Ovikian/TMEIC-DI-Water-Cooling-Skid-Repo/Documentation/Function Block Descriptions.docx

1. Startup Control Function Block

The function block will first initialize or continue to execute the diagnostics timer, or initialization timer. Boolean values associated with these timers respectively, FLAG.DIAG_DONE and FLAG.INIT_DONE will be set true once the set time has elapsed. The function block when then determines if the system is in a state which could shut down, based on current flags active. If so, the system will immediately release all latches, ignore any request for initialization, and exit. If not, the system will check if the system meets the proper conditions to initialize. If these conditions are met, the system will set the calibration latch (LATCH.CALI) and the initialization latch (LATCH.INIT) to false, and set the diagnostics latch to true. Conditions require that no fault exists, or that if a fault exists, it is bypassing. Bypassing sets all fault flags, and the master fault flag, to false, in order to allow for the system to run. (Note: this does not hide faults, but rather is a simple reset. Any fault that exists will re-trigger the faults if not dealt with properly) If initialization conditions are not met, the system will simply continue forward to the latch sequence. Once the latch sequence is complete, the function block will exit.

2. Latch Sequence

The latch sequence itself is not a function block but a critical mechanism that controls the system state within the startup control function block. This sequence determines if the system is in a diagnostics, initialization, or calibration phase. It does this by controlling three latches (LATCH.DIAG, LATCH.INIT, LATCH.CALI), three in progress flags (FLAG.DIAG_IN_PROGRESS, FLAG.INIT_IN_PROGRESS, FLAG.CALI_IN_PROGRESS) and three done flags (FLAG.DIAG_DONE, FLAG.CALI_DONE, FLAG.INIT_DONE). To enter this sequence, the diagnostics latch must be engaged – otherwise, it will exit the sequence. If engaged, the system will wait for the diagnostics phase to complete. The diagnostics phase is complete once the timer is associated with the diagnostics phase elapses. Once the diagnostics phase is complete, the function block shall enter the initialization phase. Like the diagnostics phase, the system will wait for the initialization phase to be complete through the elapses of the initialization timer. Once this timer has elapsed, the system will enter the calibration latch. Unlike the previous two phases, calibration completion is accomplished once the measured temperature satisfies temperature setpoint specifications (which is controlled outside of this function block). Only once the calibration sequence is complete, will the latch sequence conclude.

3. Fault Check

The fault check function block checks every possible fault flag. If any of the flags are true, then the system sets the master fault flag. Note that faults may be ignored by setting xSIMMODE to True.

4. Shutdown Control

The Shutdown control function block ensures that the system will shutdown under appropriate conditions, by controlling both the system on, and system shutdown flags. When entering this function block, if the system is not on, or is under nominal conditions, the system exits the function block. However, should conditions be met for a shutdown (either by the operator requesting a shutdown, or a fault-based shutdown) the system will begin to shut down, setting the shutdown in progress flag to true (FLAG.SYS_SD_IN_PROGRESS) and starting the shutdown timer. (This timer allows for the system to wind down before turning off). IN the case that the system is in the middle of diagnostics when needing the shutdown (either by the operator or through a fault), then the system will simply switch to the fault or off state (as the system has not been initialized)

5. Pump Actuation

The pump actuation function block controls the two pumps within the cooling skid. When the system enters the function block, it first will determine if the system is attempting to shut down or if the system is off. Should the system be shutting down or be off, then both pumps will receive a signal to shutdown and/or remain off. Otherwise, if the system is running, then the system will check for any request to initialize/reinitialize is active. If no request is present, the system will exit the function block. Otherwise, the non-active pump will be engaged (in the case that no pump is active, such as during a startup, then the primary pump will be engaged).

6. Fan Control

Noah’s Note: I need to modify this to meet requirements :(

7. Temperature Control

The temperature control function block serves as a filter to the PI block, to prevent controller windup, whilst also ensuring that manual control the 3-way valve is feasible. Upon entering the function block, the system will determine if the operator is manually controlling the valve. If so, the system will use the valve which the operator has provided to the system (note, the system will cap the input of the operator’s value at 0° to 90°). When the operator chooses to return control back to the system, the system shall reenter calibration mode. When the system is in calibration mode, it will compare the operator provided setpoint, with the process variable. The system will then control the valve according to the output of the PI controller such that process variable reaches or surpasses the setpoint in the appropriate direction. (That is, if the setpoint is greater than the process variable, the temperature of the system will be heated until the process variables are greater than or equal to the setpoint. The inverse is true if the setpoint is less than the process variable). Once the process variable and setpoint differences meets system requirements, the system will reset the PI controller integral (this resets the error history and prevents overshoot) and exits calibration mode. When the system is not calibrating, it will force the 3-way-valve to conform to the output of the PI controller.

8. Valve P. Controller

The valve P controller is designed to provide redundancy control to the 3-way valve position. The Kp term is set to be

9. Signal Output

The signal output function block behaves by sending the Boolean fan and pump signals to the appropriate output addresses for instrumentation actuation. Additionally, the valve position signal is converted to WORD based value between 0 and 32767, which is then sent to the 3-way valve instrument for actuation

10. Switch Latch

The switch latch function block acts as an interface between Boolean operator inputs (i.e. buttons on the HMI screen) and Boolean values within the PLC program. All inputs from the operator are debounced. If the simulation Boolean value is set to true, then the HMI mapping is ignored, and the value within the PLC (forced by the operator) is used instead. Otherwise, if the align override Boolean is set to true, then the Boolean value of the operator will always equal the Boolean value within the PLC program. Otherwise, if the toggle mode Boolean value is set to true, then the Boolean value within the PLC program will toggle between true and false, whenever the operator’s input is true. Otherwise, the Boolean value within the PLC will only be changed to true, when the operator changes the respective HMI bool to true.

11. Signal Input Analog

The signal input function block interfaces between 4-20 mA signals and the PLC. The 4-20 mA signal comes in as either a WORD or INT data type. The signal is then normalized between 0 and 1 via the maximum and minimum signal value. Then the signal is linearized between the maximum and minimum measured value. Some analog input cards have the feature to detect wire breaks, by maintaining a specific value for specific time. Should the analog input card have this ability, the analog input signal function block will detect this, and flag for a bad signal. Additionally, should the signal surpass or fall beyond the accepted maximum or minimum signal values, the function block will also detect that and flag for a bad signal.

12. Signal Input Digital

The signal input digital function block interfaces with 0-24V signal and the PLC. The 0-24V signals come is a Boolean data types. The signal is then debounced. The function block can detect rising edges and/or falling edges, if enabled, and will output TRUE when the rising and/or falling edges are detected. The function will also save the raw debounced signal.

13. Pump Evaluation

The Pump evaluation function block evaluates the pump power by multiplying together the incoming current and voltage. If either signal is considered faulty, the last used power signal will be used (or zero) and the faulty pump power flag will be raised.

14. Water Level Check

The water level check function block examines the signals coming in from the water level switches. When the water is low it will raise a flag to trigger an alarm. If the water is critically low (i.e. low low), then it will trigger a fault to shut off the system (as to not run the pumps dry). If the critical level switch becomes active, while the low-level switch remains unactive, a fault will trigger. It is impossible for the critical level to be active and for the low switch NOT to be, thus this indicates a sensor malfunction. If those level switches are not triggered then all alarm and or fault flags, will be set false.

15. Conductivity-Evaluation-Check

The conductivity check function block performs an evaluation of the coolant conductivity and ensures that the results fall below the maximum limits. The alarm level is 1 microS/cm, while the fault level is 1.1 microS/cm. The conductivity shall both output the current conductivity level of the coolant as an analog value (in microS/cm) and output two Booleans which shall be preprogrammed to go true if the conductivity reaches past the set fault and/or conductivity levels. The function block will ensure that the results of the conductivity probe align with the analog value (that is, fault or alarm trigger will be reflected both by the bool, and by the analog signal. If not, a malfunction flag shall be raised.

16. Hydraulic Evaluation

The hydraulic evaluation function examines each of the hydraulic components of the cooling skid. That is, it examines flow, pump power, and pressure. Note that pressure, unlike flow and power, is simply a Boolean that is engaged when the pressure reaches a predefined limit set within the instrument itself. Flow and pump power and compared against a minimum threshold. If these elements reach this minimum threshold, an instrument flag will be triggered according to the instrument of use. That is, should the flow reach or fall below the threshold, the low flow flag on the pumps structure shall be active. Likewise, should the pump power reach or fall below the low threshold for power, the low power flag on the pump structure shall be active.

17. Hydraulic Check

The hydraulic check function block examines the current conditions of the hydraulic system. That is, it will examine if the power, flow and/or pressure are low. The function block uses a 2 out of 3 voting scheme to determine if the results are enough to attempt a pump switch on the system. That is, is two powers, low or pressure are low together, the function block will request for the pumps to switch. Note that during diagnostics and initialization, this function block is in effect, bypassed, as the elements may be considered low, due to the pumps not in proper operation. Thus, the hydraulics will only be considered after the initialization phase.

18. Temperature Check

The temperature check function block compares the measured temperature to high and excess threshold. Should the measured temperature reach high or excess level it will trigger the respective flags (i.e., the high and excess flags). The Boolean results of the flags are debounced prior to be linked with the flags within the temperature structure.

19. Cycling Logic

The cycling logic function block is used to determine if active pump usage conditions warrant the necessity for an automatic cycling request. If pump usage surpasses as given marked usage (e.g., it has been it use at, or more than 15 hours) it will request for the pumps to be switched. Note that the function block also processes the current mode of operation (that is, if the operator has enabled simplex mode or auto cycling). If the system is in simplex mode, auto cycling CANNOT be active and will always be set to false. Otherwise, auto cycling may be toggled by the operator. In the event the operator chooses to deactivate auto cycling, it will instead raise an alarm flag to alert the operator to the pump usage.

20. Turnover Logic

The turnover logic function block processes incoming requests for a turnover, be it from a hydraulic failure, a cycling request, or an operator request, and evaluates such requests against the current state of the system. For example, a request for an automatic turnover while the system is in simplex mode, would result in a system fault, while a cycling request or a manual request would simply be rejected without further incident. In regard to automatic turnovers, while the system is running in duplex mode, an automatic turnover request will force thed system into simplex mode, due to the perceived failure of the system – which the operator must deal with. The function block also observes if the system is in any state in which trying to switch is not allowable (such as diagnostics, initialization, shutting down, or off)

21. Turnover Control

The turnover control function block takes the master turnover request flag, and with it, determines if the conditions of the system allow for a turnover (that is, the system is not shutting down, off, in diagnostics, or initializing (. If the system is ready, the turnover request will be disengaged, and a request for initialization will be made. Additionally, the initialization latch will be undone, as to allow for the initialization phase to restart. Otherwise, should the system not be ready, the system will reject the request.

22. Fan Control

The fan control function block controls the operation of both the primary and secondary fan pairs. The operator is free to switch between primary and secondary fan pairs with by engaging or disengaging the backup fan switch, or by engaging the manual fan button, which allows for the operator to freely toggle the primary and secondary fans.
