Ovikian/TMEIC-DI-Water-Cooling-Skid-Repo/Prelab Write Ups/10_22_26 Prelab Write Up.docx

Prelab Write-Up

TMEIC DI Cooling Skid
Date: 10/22/26 | Class: ECEN 404-902
Professor: Dr. Matthew Johnson | TA: Jerry Xu
Team Member Name | Subsystem
Ethan “Secondary” Henderson | Power System - EE Team Lead
Robbie Parker | Controls Hardware
Noah “Second Place” Ovikian | Controls Software

Power System/Team Lead Progress & Updates

- Ordered materials for PLC Box Mounting
- Skid fully built
- Disassembly of wooden temp board starts Thursday (10/21)
  - Hope to mount input AC bus to PLC box as well
- Flexible Panduit hose and additional 2A Type C breaker come in on Friday

Controls Hardware Progress & Updates

- Tested Flow Transmitter and Conductivity Probe
- Tested 3-way valve effect on flow rate
- Seting up alarms on HMI on 10/22

Controls Software Progress & Updates

- Created Moving Average and “Chunk” Average Algorithm for noise reduction
- Created sampling function block
- Tested Conductivity & Flow
- Work with HMI for alarm management
