Ovikian/TMEIC-DI-Water-Cooling-Skid-Repo/Prelab Write Ups/10_07_26 Prelab Write Up.docx

Prelab Write-Up

TMEIC DI Cooling Skid
Date: 10/07/26 | Class: ECEN 404-902
Professor: Dr. Matthew Johnson | TA: Jerry Xu
Team Member Name | Subsystem
His Majesty, Ethan Henderson | Power System - EE Team Lead
Robbie Parker | Controls Hardware
Noah Ovikian | Controls Software

Power System/Team Lead Progress & Updates

- Ran pump curve tested - attained pump curve
- Power system held up to transient load with fluctuating current draw from pump
- Ran heat exchanger test with fans installed
- Phase II (conductivity loop) to be constructed next week
  - MEENs occupied with Midterm Presentation and report
- Begin doing measurements for final mounting in PLC box

Controls Hardware Progress & Updates

- Tested RTD on skid with heat exchanger test
- Tested 3-Way Valve Control with HMI
- Continuing HMI screen integration with software

Controls Software Progress & Updates

- 3-Way Valve Connected, & Actuated
- 3-Way Valve Control & Communication via HMI Established
- Data Logging Implemented
- 3 - Way Valve Open Loop Test Log
- Heat Exchanger Test w/ Logged
- Aim to Work on PID Controller for 3-Way Valve
