Ovikian/TMEIC-DI-Water-Cooling-Skid-Repo/Prelab Write Ups/10_15_26 Prelab Write Up.docx

Prelab Write-Up

TMEIC DI Cooling Skid
Date: 10/15/26 | Class: ECEN 404-902
Professor: Dr. Matthew Johnson | TA: Jerry Xu
Team Member Name | Subsystem
His Majesty, Ethan Henderson | Power System - EE Team Lead
Robbie Parker | Controls Hardware
His Majesty’s Underling, Noah Ovikian | Controls Software

Power System/Team Lead Progress & Updates

- Phase I, II (partial), and III (partial) test results collected
- Started modeling to mount components in PLC box (TMEIC gave preferences on construction)
- Phase II (full) test Thursday (10/15) afternoon - ECEN setup (wiring and comms) to be done in the morning

Controls Hardware Progress & Updates

- Continued testing of 3 way valve
- Added state indicator to HMI
- Testing flow and conductivity transmitters on 10/15

Controls Software Progress & Updates

- P Controller Tuned for 3-way valve
- Condensed Regulation Algorithms into Single Anti-Windup Algorithm
- Conductivity Tests & Flow Meter Tests
