Ovikian/TMEIC-DI-Water-Cooling-Skid-Repo/Prelab Write Ups/10_01_26 Prelab Write Up.docx

Prelab Write-Up

TMEIC DI Cooling Skid
Date: 10/01/26 | Class: ECEN 404-902
Professor: Dr. Matthew Johnson | TA: Jerry Xu
Team Member Name | Subsystem
Ethan Henderson | Power System - EE Team Lead
Robbie Parker | Controls Hardware
Noah Ovikian | Controls Software

Power System/Team Lead Progress & Updates

- Assembled full power system as initially designed
  - There are some new loads that were added so we need to do slight design changes
- Constructed prototype board with all available power system components
  - This will serve as the test bed for instrument wiring and to measure wiring lengths for eventual mounting into the PLC box
- Pump curve test in the morning (Phase I) | Heating loop test in the afternoon (Phase III)
  - Phase II skid wasn’t put together correctly so we have to delay that

Controls Hardware Progress & Updates

- Updated HMI screen to include P&ID
- Installed Fan Relays
- Tested Communication between PLC and Conductivity Transmitter

Controls Software Progress & Updates

- PLC Point List Complete
- Digital Twin Revamped
- Continue to map variables to instruments and HMI
- Begin looking into 3-way valve
- Explore data logging
