Ovikian/TMEIC-DI-Water-Cooling-Skid-Repo/Prelab Write Ups/9_24_26 Prelab Write Up.docx

Prelab Write-Up

TMEIC DI Cooling Skid
Date: 9/24/26 | Class: ECEN 404-902
Professor: Dr. Matthew Johnson | TA: Jerry Xu
Team Member Name | Subsystem
Ethan Henderson | Power System - EE Team Lead
Robbie Parker | Controls Hardware
Noah Ovikian | Controls Software

Power System/Team Lead Progress & Updates

- Established new water testing agreement with FEDC
  - We can have multiple days of water testing per week instead of just one
- Worked with MEEN TL to draft, sign, and send out a Project Success Agreement
  - Established expectations for final skid functionality and put a freeze of scope changes
- Received ALL Power System components and assembled the prototype for the control/power system
  - Controls Power System + Pump Power System
- Completed first set of Phase I tests - pressure
  - Flow rate will be done in the afternoon
- Validated Controls Power System and Pump Power System through Phase I Tests - took a video

Controls Hardware Progress & Updates

- Updated HMI program to include power readings
- Installed voltage and current monitors
- Installed pump relays

Controls Software Progress & Updates

- COMMs with HMI Established
- Rev A of point list completed, Rev B of control narrative complete
- Updated Digital Twin w/ hydraulics, sized HX, pumps, & 3-way-valve
- Wrote simple Phase 1 PLC program
- Work on PLC logic, discuss simulation results
