Ovikian/TMEIC-DI-Water-Cooling-Skid-Repo/MATLAB/untitled1.png

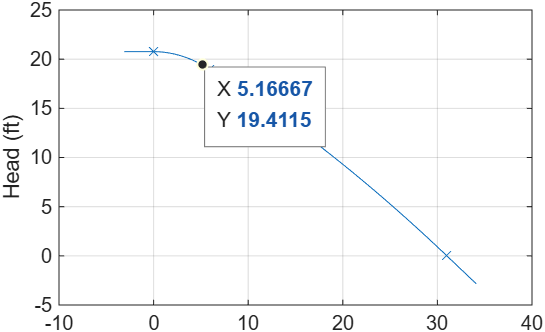
MATLAB/untitled1.png
