Ovikian/TMEIC-DI-Water-Cooling-Skid-Repo/Testing Documentation/Control System Software Testing Sheet.xlsx

Component | Subcomponent | Test | Result | Proof | Completed | Skid Required For Testing | Skid Components Needed
Sequences | Cold Start Delay | System Startup Delay Time Honored |  |  | FALSE | FALSE
Sequences | Cold Start Delay | Clean Variables Observed |  |  | FALSE | FALSE
Sequences | Standby-Startup | Startup Saturation Observed |  |  | FALSE | FALSE
Sequences | Standby-Startup | Cold Start Check Time Honored |  |  | FALSE | FALSE
Sequences | Standby-Startup | Cold Start Stop Observed |  |  | FALSE | FALSE
Sequences | Standby-Startup | Initialization Time Honored |  |  | FALSE | FALSE
Sequences | Standby-Startup | Disabled Pump Control at Init Observed |  |  | FALSE | FALSE
Sequences | Standby-Startup | Disabled Temp Control at Init Observed |  |  | FALSE | FALSE
Sequences | Standby-Startup | Calibration Time Honored |  |  | FALSE | FALSE
Sequences | Standby-Startup | Enabled Pump Control at Cali Observed |  |  | FALSE | FALSE
Sequences | Standby-Startup | Part-Enabled Temp Control at Cali Observed |  |  | FALSE | FALSE
Sequences | Standby-Startup | Enabled Pump Control at Nominal Observed |  |  | FALSE | FALSE
Sequences | Standby-Startup | Enabled Temp Control at Nominal |  |  | FALSE | FALSE
Sequences | Pulse | Initialization Time Honored |  |  | FALSE | FALSE
Sequences | Pulse | Disabled Pump Control at Init Observed |  |  | FALSE | FALSE
Sequences | Pulse | Disabled Temp Control at Init Observed |  |  | FALSE | FALSE
Sequences | Pulse | Calibration Time Honored |  |  | FALSE | FALSE
Sequences | Pulse | Enabled Pump Control at Cali Observed |  |  | FALSE | FALSE
Sequences | Pulse | Part-Enabled Temp Control at Cali Observed |  |  | FALSE | FALSE
Sequences | Pulse | Enabled Pump Control at Nominal Observed |  |  | FALSE | FALSE
Sequences | Pulse | Enabled Temp Control at Nominal |  |  | FALSE | FALSE
Sequences | Fault-Startup | Startup Rejection Observed |  |  | FALSE | FALSE
Sequences | Fault-Startup | Fault Clearance & Startup Observed |  |  | FALSE | FALSE
Sequences | Fault-Startup | Startup Saturation Observed |  |  | FALSE | FALSE
Sequences | Fault-Startup | Cold Start Check Time Honored |  |  | FALSE | FALSE
Sequences | Fault-Startup | Cold Start Stop Observed |  |  | FALSE | FALSE
Sequences | Fault-Startup | Initialization Time Honored |  |  | FALSE | FALSE
Sequences | Fault-Startup | Disabled Pump Control at Init Observed |  |  | FALSE | FALSE
Sequences | Fault-Startup | Disabled Temp Control at Init Observed |  |  | FALSE | FALSE
Sequences | Fault-Startup | Calibration Time Honored |  |  | FALSE | FALSE
Sequences | Fault-Startup | Enabled Pump Control at Cali Observed |  |  | FALSE | FALSE
Sequences | Fault-Startup | Part-Enabled Temp Control at Cali Observed |  |  | FALSE | FALSE
Sequences | Fault-Startup | Enabled Pump Control at Nominal Observed |  |  | FALSE | FALSE
Sequences | Shutdown | Force Shutdown Observed |  |  | FALSE | FALSE
Sequences | Shutdown | Fault Shutdown Observed |  |  | FALSE | FALSE
Sequences | Shutdown | Temp Control Disabled Observed |  |  | FALSE | FALSE
Sequences | Shutdown | Temp Values Maintained Observed |  |  | FALSE | FALSE
Sequences | Shutdown | Pumps Off Observed |  |  | FALSE | FALSE
Sequences | Shutdown | Valve Fail Safe Observed |  |  | FALSE | FALSE
Sequences | Shutdown | Fan Fail Safe Observed |  |  | FALSE | FALSE
Sequences | Shutdown | Force Shutdown Saturation Check |  |  | FALSE | FALSE
Instrumentation | Voltage Observation | Voltage Measurement Observed | Voltage from multimeter observed |  | TRUE | FALSE
Instrumentation | Voltage Observation | Voltage Measurement Accurate |  |  | FALSE | FALSE
 |  | Voltage Measurement Dynamics | Change in Voltage was accounted for, both shown in HMI and on |  | FALSE | FALSE
Instrumentation | Current Obervation | Current Signal Observed | Current from multimeter observed |  | TRUE | FALSE
Instrumentation | Current Obervation | Current Signal Accurate |  |  | FALSE | FALSE
Instrumentation | Flow Observation | Flow Measurement Observation |  |  | FALSE | TRUE | Flow Meter Inline Connection
Instrumentation | Flow Observation | Flow Measurement Accurate (~<=10% Error) |  |  | FALSE | TRUE | Flow Meter Inline Connection
Instrumentation | Flow Observation | Flow Signal Low Trigger |  |  | FALSE | TRUE | Flow Meter Inline Connection
Instrumentation | Flow Observation | Flow Signal Low Accurate |  |  | FALSE | TRUE | Flow Meter Inline Connection
Instrumentation | Flow Observation | Flow Signal Not Low Trigger |  |  | FALSE | TRUE | Flow Meter Inline Connection
Instrumentation | Flow Observation | Flow Signal Not Low Accurate (~<=10% Error) |  |  | FALSE | TRUE | Flow Meter Inline Connection
Instrumentation | Flow Observation | Flow Signal Dynamics Observed |  |  | FALSE | TRUE | Flow Meter Inline Connection
Instrumentation | Flow Observation | Low Trigger Hysteresis |  |  | FALSE | TRUE | Flow Meter Inline Connection
Instrumentation | Pressure Observation | Pressure Switch On Observed |  |  | FALSE | FALSE
Instrumentation | Pressure Observation | Pressure Switch Off Observed |  |  | FALSE | FALSE
Instrumentation | Pressure Observation | Pressure Switch Dynamics Observed |  |  | FALSE | FALSE
Instrumentation | Pressure Observation | Pressure Switch On Trigger Accurate (~<=10% Error) |  |  | FALSE | FALSE
Instrumentation | Pressure Observation | Pressure Switch Off Trigger Accurate (~<=10% Error) |  |  | FALSE | FALSE
Instrumentation | Pressure Observation | Hysteresis Check |  |  | FALSE | FALSE
Instrumentation | Low Level Observation | Low Level True Obervation |  |  | FALSE | FALSE
Instrumentation | Low Level Observation | Low Level True Accurate (~<=10% Error) |  |  | FALSE | FALSE
Instrumentation | Low Level Observation | Low Level False Observation |  |  | FALSE | FALSE
Instrumentation | Low Level Observation | Low Level Dynamics Observation |  |  | FALSE | FALSE
Instrumentation | Low Level Observation | Low Level Hystresis Check |  |  | FALSE | TRUE | Instaled Low Level Switch
Instrumentation | Low Low Observation | Low Low Level True Observation |  |  | FALSE | FALSE
Instrumentation | Low Low Observation | Low Low Level True Accurate (~<=10% Error) |  |  | FALSE | FALSE
Instrumentation | Low Low Observation | Low Low Level False Observation |  |  | FALSE | FALSE
Instrumentation | Low Low Observation | Low Low Level False Accurate (~<=10% Error) |  |  | FALSE | FALSE
Instrumentation | Low Low Observation | Low Level Dynamics Observation |  |  | FALSE | FALSE
Instrumentation | Low Low Observation | Low Level Hystresis Check |  |  | FALSE | TRUE | Installed Low Low Level Switch
Instrumentation | RTD 1 Observation | Temp 1 Observation |  |  | FALSE | FALSE
Instrumentation | RTD 1 Observation | Temp 1 Accurate |  |  | FALSE | TRUE | Installed RTD Probe
Instrumentation | RTD 1 Observation | Temp 1 Dynamics |  |  | FALSE | FALSE
Instrumentation | RTD 2 Observation | Temp 2 Observation |  |  | FALSE | FALSE
Instrumentation | RTD 2 Observation | Temp 2 Accurate (~<=10% Error) |  |  | FALSE | TRUE | Installed RTD Probe
Instrumentation | RTD 2 Observation | Temp 2 Dynamics |  |  | FALSE | FALSE
Instrumentation | RTD 3 Observation | Temp 3 Observation |  |  | FALSE | FALSE
Instrumentation | RTD 3 Observation | Temp 3 Accurate (~<=10% Error) |  |  | FALSE | TRUE | Installed RTD Probe
Instrumentation | RTD 3 Observation | Temp 3 Dynamics Observed |  |  | FALSE | FALSE
Instrumentation | 3-Way Valve Control | Fully Open Control Observed |  |  | FALSE | FALSE
Instrumentation | 3-Way Valve Control | Fully Closed Observed |  |  | FALSE | FALSE
Instrumentation | 3-Way Valve Control | Opening-Closing Dynamics Observed |  |  | FALSE | FALSE
Instrumentation | 3-Way Valve Control | 75% Open Observed |  |  | FALSE | FALSE
Instrumentation | 3-Way Valve Control | 50% Open Observed |  |  | FALSE | FALSE
Instrumentation | 3-Way Valve Control | 25% Open Observed |  |  | FALSE | FALSE
Instrumentation | 3-Way Valve Observation | Position Measurement Observed |  |  | FALSE | FALSE
Instrumentation | 3-Way Valve Observation | Position Measurement Accurate |  |  | FALSE | FALSE
Instrumentation | Pump Control | Primary Pump On Observed |  |  | FALSE | FALSE
Instrumentation | Pump Control | Primary Pump Off Observed |  |  | FALSE | FALSE
Instrumentation | Pump Control | Primary Pump Dynamics Obsrved |  |  | FALSE | FALSE
Instrumentation | Pump Control | Secondary Pump On Observed |  |  | FALSE | FALSE
Instrumentation | Pump Control | Secondary Pump Off Observed |  |  | FALSE | FALSE
Instrumentation | Pump Control | Secondary Pump Dyanmics Observed |  |  | FALSE | FALSE
Instrumentation | Fan Control | Fan On Observed |  |  | FALSE | FALSE
Instrumentation | Fan Control | Fan Off Observed |  |  | FALSE | FALSE
Instrumentation | Fan Control | Fan Dyanimcs Observed |  |  | FALSE | FALSE
Instrumentation | Conductivity | Condictuvity Alarm Observed |  |  | FALSE | FALSE
Instrumentation | Conductivity | Conductivity Alarm Accurate |  |  | FALSE | TRUE | Installed Conductivity Meter
Instrumentation | Conductivity | Conductivity Fault Observed |  |  | FALSE | FALSE
Instrumentation | Conductivity | Conductivity Fault Accurate |  |  | FALSE | TRUE | Installed Conductivity Meter
Instrumentation | Conductivity | Condcutivity Measurement Observed |  |  | FALSE | FALSE
Instrumentation | Conductivity | Condcutivity Measurement Accurate |  |  | FALSE | TRUE | Installed Conductivity Meter
Instrumentation | Conductivity | Conductivity Alarm-Measurement Aggrement Accurate |  |  | FALSE | TRUE | Installed Conductivity Meter
Instrumentation | Conductivity | Conducitvity Fault-Measurement Aggreeemtn Accurate |  |  | FALSE | TRUE | Installed Conductivity Meter
Instrumentation | Pump Observation | Pump Power Observed |  |  | FALSE | TRUE | Installed Pump
Instrumentation | Pump Observation | Pump Power Accurate |  |  | FALSE | TRUE | Installed Pump
Instrumentation | Pump Observation | Low Pump Power Trigger Observed |  |  | FALSE | TRUE | Installed Pump
Instrumentation | Pump Observation | Low Pump Power Trigger Accurate |  |  | FALSE | TRUE | Installed Pump
Instrumentation | Pump Observation | SS Trigger Observed |  |  | FALSE | FALSE
Instrumentation | Pump Observation | SS Trigger Accurate |  |  | FALSE | FALSE
Hydraulic Control | Manual Pump Switching | Switchability Observed |  |  | FALSE | FALSE
Hydraulic Control | Manual Pump Switching | No Switch on Simplex Mode Observed |  |  | FALSE | FALSE
Hydraulic Control | Manual Pump Switching | No switch on check, init, calibration, shutdown states |  |  | FALSE | FALSE
Hydraulic Control | Manual Pump Switching | Saturation Check |  |  | FALSE | FALSE
Hydraulic Control | Hydraulic Failure Pump Switching | Automatic Switching Observed |  |  | FALSE | FALSE
Hydraulic Control | Hydraulic Failure Pump Switching | Simplex Mode Activation Observed |  |  | FALSE | FALSE
Hydraulic Control | Hydraulic Failure Pump Switching | Bingo Pumps Observed |  |  | FALSE | FALSE
Hydraulic Control | Hydraulic Failure Pump Switching | No Switch on check, init, cali, or shutdown |  |  | FALSE | FALSE
Hydraulic Control | Hydraulic Failure Pump Switching | Maulfunction Sensor as Low Honored |  |  | FALSE | FALSE
Hydraulic Control | Lifecycle Pump Switching | Automatic Switching Observed | When pump lifcycle is engaged, automatic pump switching occurs, per the increment |  | TRUE | FALSE
Hydraulic Control | Lifecycle Pump Switching | No Swithing in Simplex Mode Observed | Automatic lifecycle is disengaged when Simplex Mode is active |  | TRUE | FALSE
Hydraulic Control | Lifecycle Pump Switching | Joker Alarm in Simplex Mode Observed |  |  | FALSE | FALSE
Hydraulic Control | Lifecycle Pump Switching | No Joker Alarm in Duplex Mode |  |  | FALSE | FALSE
Hydraulic Control | Lifecycle Pump Switching | No switch on check, init, cali, or shutdown |  |  | FALSE | FALSE
Temperature Control | Temperature Regulation | Temperature Setpoint Maintained |  |  | FALSE | TRUE | Installed 2 RTD, 3-Way Valve
Temperature Control | Temperature Regulation | Temperature alarm at alarm setpoint observed |  |  | FALSE | FALSE
Temperature Control | Temperature Regulation | Temperature fault at fault setpoint observed |  |  | FALSE | FALSE
Temperature Control | Temperature Regulation | Temperature alarm at alarm setpoint A |  |  | FALSE | FALSE
Temperature Control | Temperature Regulation | Temperature fault at fault setpoint A |  |  | FALSE | FALSE
Temperature Control | Temperature Regulation | Temperatuer OK observed |  |  | FALSE | FALSE
Temperature Control | Temperature Regulation | Temperature OK accurate |  |  | FALSE | FALSE
Temperature Control | Temperature Regulation | Temperature dyanmics |  |  | FALSE | FALSE
Temperature Control | Temperature Regulation | Init, cali, and shutdown overrides observed |  |  | FALSE | FALSE
Temperature Control | Temperature Regulation | Init, cali, and shutdown overrides Accurate |  |  | FALSE | FALSE
Temperature Control | Temperature Regulation | Time thresholds honored |  |  | FALSE | FALSE
Temperature Control | Temperature Regulation | Fail-safe position of valve observed during non-control |  |  | FALSE | FALSE
Temperature Control | Temperature Regulation | Fail-safe position of valve observed during non-control A |  |  | FALSE | FALSE
Temperature Control | Temperature Regulation | Fail-safe position of Fan observed during non-control |  |  | FALSE | FALSE
Temperature Control | Temperature Regulation | Fail-safe position of Fan observed during non-control A |  |  | FALSE | FALSE
Temperature Control | Temperature Regulation | Manual Valve Mode Override Observed (DM) |  |  | FALSE | FALSE
Temperature Control | Temperature Regulation | Manual Fan Mode Override Observed (DM) | Enabled Manual Fan Mode on HMI. Able to control fan 1 and fan 2. Disabling allowed automatic control |  | TRUE | FALSE
Temperature Control | Temperature Measurement | Median of 3 Temps Observed |  |  | FALSE | FALSE
Temperature Control | Temperature Measurement | Median of 3 Temps Accurate |  |  | FALSE | FALSE
Temperature Control | Temperature Measurement | Average of 2 Temps Observed |  |  | FALSE | FALSE
Temperature Control | Temperature Measurement | Average of 2 Temps Accurate |  |  | FALSE | FALSE
Temperature Control | Temperature Measurement | Fault on 1 |  |  | FALSE | FALSE
Vessel Level Control | Low Alarm | Low Alarm Trigger Observed |  |  | FALSE | FALSE
Vessel Level Control | Low Alarm | Low Alarm False Observed |  |  | FALSE | FALSE
Vessel Level Control | Low Alarm | Low Alarm Trigger Accurate |  |  | FALSE | FALSE
Vessel Level Control | Low Alarm | Low Alarm False Accurate |  |  | FALSE | FALSE
Vessel Level Control | Low Alarm | Low Alarm Dynamics Observed |  |  | FALSE | FALSE
Vessel Level Control | Low Alarm | Low Alarm Trigger A |  |  | FALSE | FALSE
Vessel Level Control | Low Alarm | Low Alarm False A |  |  | FALSE | FALSE
Vessel Level Control | Low Alarm | Hysteresis Check |  |  | FALSE | TRUE | Installed 2 Level Switches
Vessel Level Control | Low Fault | Low Fault Trigger Obsereved |  |  | FALSE | FALSE
Vessel Level Control | Low Fault | Malfunction Fault Trigger Observed |  |  | FALSE | FALSE
Vessel Level Control | Low Fault | Low Fault Trigger Accurate |  |  | FALSE | FALSE
Vessel Level Control | Low Fault | Malfunction Fault Accurate |  |  | FALSE | FALSE
Vessel Level Control | Low Fault | Hysteresis Check |  |  | FALSE | TRUE | Installed 2 Level Switches
Conductivity Control | Conductivty Alarm | Alarm Trigger Observed |  |  | FALSE | TRUE | Installed Conductivity Meter
Conductivity Control | Conductivty Alarm | Alarm Trigger Accurate |  |  | FALSE | TRUE | Installed Conductivity Meter
Conductivity Control | Conductivty Alarm | Alarm Flase Observed |  |  | FALSE | TRUE | Installed Conductivity Meter
Conductivity Control | Conductivty Alarm | Alarm False Accurate |  |  | FALSE | TRUE | Installed Conductivity Meter
Conductivity Control | Conductivty Alarm | Alarm Dynamics |  |  | FALSE | TRUE | Installed Conductivity Meter
Conductivity Control | Conductivty Alarm | Malfunction Trigger Observed |  |  | FALSE | TRUE | Installed Conductivity Meter
Conductivity Control | Conductivty Alarm | Malfunction Trigger Accurate |  |  | FALSE | TRUE | Installed Conductivity Meter
Conductivity Control | Conductivty Alarm | Time Thresholds Honored |  |  | FALSE | TRUE | Installed Conductivity Meter
Conductivity Control | Conductivty Alarm | Hysteresis Check |  |  | FALSE | TRUE | Installed Conductivity Meter
Conductivity Control | Conductivity Fault | Fault Trigger Observed |  |  | FALSE | TRUE | Installed Conductivity Meter
Conductivity Control | Conductivity Fault | Fault Trigger Accurate |  |  | FALSE | TRUE | Installed Conductivity Meter
Conductivity Control | Conductivity Fault | Malfunction Trigger Observed |  |  | FALSE | TRUE | Installed Conductivity Meter
Conductivity Control | Conductivity Fault | Malfunction Trigger Accurate |  |  | FALSE | TRUE | Installed Conductivity Meter
Conductivity Control | Conductivity Fault | Time Thresholds Honored |  |  | FALSE | TRUE | Installed Conductivity Meter
Conductivity Control | Conductivity Fault | Hysteresis Check |  |  | FALSE | TRUE | Installed Conductivity Meter
Signal | Switch | Master Switch Connection |  |  | FALSE | FALSE
Signal | Switch | System Start Connection |  |  | FALSE | FALSE
Signal | Switch | System Shutdown Connection |  |  | FALSE | FALSE
Signal | Switch | Simplex Mode Connection |  |  | FALSE | FALSE
Signal | Switch | Manual Turnover Connection |  |  | FALSE | FALSE
Signal | Switch | Enable Manual Valve Control Connection |  |  | FALSE | FALSE
Signal | Switch | Enable Manual Fan Control Connection |  |  | FALSE | FALSE
Signal | Switch | Force Fan 1 On/Off SIGNAL CONNECTED |  |  | FALSE | FALSE
Signal | Switch | Force Fan 2 On/Off SIGNAL CONNECTED |  |  | FALSE | FALSE
Signal | Switch | Primary Hydraulic Fault ACK SIGNAL CONNECTED |  |  | FALSE | FALSE
Signal | Switch | Secondary Hydraulic Fault ACK SIGNAL CONNECTED |  |  | FALSE | FALSE
Signal | Switch | Enable Pump Cycling SIGNAL CONNECTED |  |  | FALSE | FALSE
Signal | Switch | Reset Pump Differential Signal SIGNAL CONNECTED |  |  | FALSE | FALSE
Signal | Switch | Fault ACK SIGNAL CONNECTED |  |  | FALSE | FALSE
Signal | Switch | Pump 1 EOL Ack SIGNAL CONNECTED |  |  | FALSE | FALSE
Signal | Switch | Pump 2 EOL Ack SIGNAL CONNECTED |  |  | FALSE | FALSE
Signal | Internal | System On SIGNAL CONNECTED |  |  | FALSE | FALSE
Signal | Internal | System Shutting Down SIGNAL CONNECTED |  |  | FALSE | FALSE
Signal | Internal | System Initializing SIGNAL CONNECTED |  |  | FALSE | FALSE
Signal | Internal | System Calibrating SIGNAL CONNECTED |  |  | FALSE | FALSE
Signal | Internal | Measured Pump Power SIGNAL CONNECTED |  |  | FALSE | FALSE
Signal | Internal | Measured Inlet Coolant Temperature SIGNAL CONNECTED |  |  | FALSE | FALSE
Signal | Internal | Measured Conductivity SIGNAL CONNECTED |  |  | FALSE | FALSE
Signal | Internal | Measured Flow SIGNAL CONNECTED |  |  | FALSE | FALSE
Signal | Internal | Valve Open Percentage SIGNAL CONNECTED |  |  | FALSE | FALSE
Signal | Internal | Real Pump1 Power Signal SIGNAL CONNECTED |  |  | FALSE | FALSE
Signal | Internal | Real Pump 2 Power Signal SIGNAL CONNECTED |  |  | FALSE | FALSE
Signal | Internal | Output Water Level Low Signal SIGNAL CONNECTED |  |  | FALSE | FALSE
Signal | Internal | Output Water Level Low Low Signal SIGNAL CONNECTED |  |  | FALSE | FALSE
Signal | Internal | Output Pressure Signal SIGNAL CONNECTED |  |  | FALSE | FALSE
Signal | Internal | Output Conductivity Alarm Signal SIGNAL CONNECTED |  |  | FALSE | FALSE
Signal | Internal | Output Conductivity Fault Signal SIGNAL CONNECTED |  |  | FALSE | FALSE
Signal | Internal | Measured Pump 1 Voltage SIGNAL CONNECTED |  |  | FALSE | FALSE
Signal | Internal | Measured Pump 1 Current SIGNAL CONNECTED |  |  | FALSE | FALSE
Signal | Internal | Measured Pump 2 Voltage SIGNAL CONNECTED |  |  | FALSE | FALSE
Signal | Internal | Measured Pump 2 Current SIGNAL CONNECTED |  |  | FALSE | FALSE
Signal | Internal | Pump 1 Total Hours SIGNAL CONNECTED |  |  | FALSE | FALSE
Signal | Internal | Pump 2 Total Hours SIGNAL CONNECTED |  |  | FALSE | FALSE
Signal | Alarm | High Coolant Temperature SIGNAL CONNECTED |  |  | FALSE | FALSE
Signal | Alarm | Low Coolant Level in Vessel SIGNAL CONNECTED |  |  | FALSE | FALSE
Signal | Alarm | High Coolant Conductivity SIGNAL CONNECTED |  |  | FALSE | FALSE
Signal | Alarm | Low Hydraulic Power SIGNAL CONNECTED |  |  | FALSE | FALSE
Signal | Alarm | Low Hydraulic Flow SIGNAL CONNECTED |  |  | FALSE | FALSE
Signal | Alarm | Low Hydraulic Pressure SIGNAL CONNECTED |  |  | FALSE | FALSE
Signal | Alarm | Primary Power Signal Malfunction SIGNAL CONNECTED |  |  | FALSE | FALSE
Signal | Alarm | Secondary Power Signal Malfunction SIGNAL CONNECTED |  |  | FALSE | FALSE
Signal | Alarm | Primary Hydraulic Failure SIGNAL CONNECTED |  |  | FALSE | FALSE
Signal | Alarm | Secondary Hydraulic Failure SIGNAL CONNECTED |  |  | FALSE | FALSE
Signal | Alarm | Automatic Valve Control Disabled SIGNAL CONNECTED |  |  | FALSE | FALSE
Signal | Alarm | Automatic Fan Control Disabled SIGNAL CONNECTED |  |  | FALSE | FALSE
Signal | Alarm | Flow Signal Malfunction SIGNAL CONNECTED |  |  | FALSE | FALSE
Signal | Alarm | Bad RTD 1 Signal SIGNAL CONNECTED |  |  | FALSE | FALSE
Signal | Alarm | Bad RTD 2 Signal SIGNAL CONNECTED |  |  | FALSE | FALSE
Signal | Alarm | Bad RTD 3 Signal SIGNAL CONNECTED |  |  | FALSE | FALSE
Signal | Alarm | Pump Cycle Alarm SIGNAL CONNECTED |  |  | FALSE | FALSE
Signal | Fault | Critical Temperature SIGNAL CONNECTED |  |  | FALSE | FALSE
Signal | Fault | Critical Vessel Level SIGNAL CONNECTED |  |  | FALSE | FALSE
Signal | Fault | Critical Conductivity SIGNAL CONNECTED |  |  | FALSE | FALSE
Signal | Fault | Level Sensor Malfunction SIGNAL CONNECTED |  |  | FALSE | FALSE
Signal | Fault | Conductivity Sensor Malfunction SIGNAL CONNECTED |  |  | FALSE | FALSE
Signal | Fault | Duplex Failure SIGNAL CONNECTED |  |  | FALSE | FALSE
Signal | Fault | Temperatur Sensor Malfunction SIGNAL CONNECTED |  |  | FALSE | FALSE
Signal | Fault | Overflow/EOTW SIGNAL CONNECTED |  |  | FALSE | FALSE
Signal | Fault | Master Fault Signal SIGNAL CONNECTED |  |  | FALSE | FALSE
Signal | Physical | Flow Sensor Input SIGNAL CONNECTED |  |  | FALSE | FALSE
Signal | Physical | RTD 1 SIGNAL CONNECTED |  |  | FALSE | FALSE
Signal | Physical | RTD 2 SIGNAL CONNECTED |  |  | FALSE | FALSE
Signal | Physical | RTD 3 SIGNAL CONNECTED |  |  | FALSE | FALSE
Signal | Physical | Conductivity SIGNAL CONNECTED |  |  | FALSE | FALSE
Signal | Physical | Conductivity Alarm SIGNAL CONNECTED |  |  | FALSE | FALSE
Signal | Physical | Conductivity Fault SIGNAL CONNECTED |  |  | FALSE | FALSE
Signal | Physical | Level Low Switch SIGNAL CONNECTED |  |  | FALSE | FALSE
Signal | Physical | Level Low Low Switch SIGNAL CONNECTED |  |  | FALSE | FALSE
Signal | Physical | Fan 1 Enable SIGNAL CONNECTED |  |  | FALSE | FALSE
Signal | Physical | Fan 2 Enable SIGNAL CONNECTED |  |  | FALSE | FALSE
Signal | Physical | Pump 1 Enable SIGNAL CONNECTED |  |  | FALSE | FALSE
Signal | Physical | Pump 2 Enable SIGNAL CONNECTED |  |  | FALSE | FALSE
Signal | Physical | Valve Actuation Signal SIGNAL CONNECTED |  |  | FALSE | FALSE
Signal | Physical | Pressure Switch Signal SIGNAL CONNECTED |  |  | FALSE | FALSE
Signal | Physical | Active Pump Current SIGNAL CONNECTED |  |  | FALSE | FALSE
Signal | Physical | Active Pump Voltage SIGNAL CONNECTED |  |  | FALSE | FALSE
