Ovikian/TMEIC-DI-Water-Cooling-Skid-Repo/Documentation/PLC Point List.xlsx

Sheet: Point List
Signal Type | Tag No | Name | N/A | Status | Data Type | Memory Type | PDU Hexadecimal | Modbus Address | Modicon Address | Proface Type | Proface Data Type | Size (Bits) | PLC Memory Address | Position | I/O Card Number | Channel | I/O | Global Variable | Program Variable Name | Operator Visiblity | Deadman | Linked | Validation
Switch | SW-0 | Master_Switch | SYSTEM | IN-USE | N/A | N/A | N/A | N/A | N/A | N/A | REMOVE | N/A | N/A | N/A | N/A | N/A | N/A | N/A | XXX | YES | NO | TRUE
Switch | SW-1 | System_Start | SYSTEM | IN-USE | BOOL | FLAG | 0x3000 | 12288 | 012289 | MOMENTARY | BitAddress | 1 | %MX0.0 | N/A | N/A | N/A | N/A | NO | axSW[] | YES | NO | TRUE | TRUE
Switch | SW-2 | System_Shutdown | SYSTEM | IN-USE | BOOL | FLAG | 0x3001 | 12289 | 012290 | MOMENTARY | BitAddress | 1 | %MX0.1 | N/A | N/A | N/A | N/A | NO | axSW[] | YES | NO | TRUE | TRUE
Switch | SW-3 | Simplex_Mode | PUMP | IN-USE | BOOL | FLAG | 0x3002 | 12290 | 012291 | MOMENTARY | BitAddress | 1 | %MX0.2 | N/A | N/A | N/A | N/A | NO | axSW[] | YES | NO | TRUE | TRUE
Switch | SW-4 | Manual_Turnover | PUMP | IN-USE | BOOL | FLAG | 0x3003 | 12291 | 012292 | MOMENTARY | BitAddress | 1 | %MX0.3 | N/A | N/A | N/A | N/A | NO | axSW[] | YES | NO | TRUE | TRUE
Switch | SW-5 | Enable_Manual_Valve_Control | VALVE | IN-USE | BOOL | FLAG | 0x3004 | 12292 | 012293 | BIT INVERT | BitAddress | 1 | %MX0.4 | N/A | N/A | N/A | N/A | NO | axSW[] | YES | YES | TRUE | TRUE
Switch | SW-6 | Enable_Manual_Fan_Control | FAN | IN-USE | BOOL | FLAG | 0x3005 | 12293 | 012294 | BIT INVERT | BitAddress | 1 | %MX0.5 | N/A | N/A | N/A | N/A | NO | axSW[] | YES | YES | TRUE | TRUE
Switch | SW-7 | Update_Setpoint | N/A | IN-USE | BOOL | FLAG | 0x3006 | 12294 | 012295 | N/A | BitAddress | 1 | %MX0.6 | N/A | N/A | N/A | N/A | NO | axSW[] | YES | NO | TRUE | FALSE
Switch | SW-8 | Force_Fan_1_On_Off | FAN | IN-USE | BOOL | FLAG | 0x3007 | 12295 | 012296 | BIT INVERT | BitAddress | 1 | %MX0.7 | N/A | N/A | N/A | N/A | NO | axSW[] | YES | NO | TRUE | TRUE
Switch | SW-9 | Force_Fan_2_On_Off | FAN | IN-USE | BOOL | FLAG | 0x3008 | 12296 | 012297 | BIT INVERT | BitAddress | 1 | %MX0.8 | N/A | N/A | N/A | N/A | NO | axSW[] | YES | NO | TRUE | TRUE
Switch | SW-10 | Engage_Backup_Fans | Fans | IN-USE | BOOL | FLAG | 0x3009 | 12297 | 012298 | BIT INVERT | BitAddress | 1 | %MX0.9 | N/A | N/A | N/A | N/A | NO | axSW[] | YES | NO | TRUE | FALSE
Switch | SW-11 | AVAILABLE | N/A | AVAILABLE | BOOL | FLAG | 0x300A | 12298 | 012299 | N/A | REMOVE | 1 | %MX0.10 | N/A | N/A | N/A | N/A | NO | axSW[] | YES | NO | TRUE | N/A
Switch | SW-12 | Enable_Pump_Cycling | PUMP | IN-USE | BOOL | FLAG | 0x300B | 12299 | 012300 | MOMENTARY | BitAddress | 1 | %MX0.11 | N/A | N/A | N/A | N/A | NO | axSW[] | YES | NO | TRUE | TRUE
Switch | SW-13 | Reset_Pump_Differential_Signal | PUMP | IN-USE | BOOL | FLAG | 0x300C | 12300 | 012301 | MOMENTARY | BitAddress | 1 | %MX0.12 | N/A | N/A | N/A | N/A | NO | axSW[] | YES | NO | TRUE | TRUE
Switch | SW-14 | Fault_Override | SYSTEM | IN-USE | BOOL | FLAG | 0x300D | 12301 | 012302 | BIT INVERT | BitAddress | 1 | %MX0.13 | N/A | N/A | N/A | N/A | NO | axSW[] | YES | NO | TRUE | TRUE
Switch | SW-15 | AVAILABLE | N/A | AVAILABLE | BOOL | FLAG | 0x300E | 12302 | 012303 | N/A | REMOVE | 1 | %MX0.14 | N/A | N/A | N/A | N/A | NO | axSW[] | YES | NO | TRUE | N/A
Switch | SW-16 | AVAILABLE | N/A | AVAILABLE | BOOL | FLAG | 0x300F | 12303 | 012304 | N/A | REMOVE | 1 | %MX0.15 | N/A | N/A | N/A | N/A | NO | axSW[] | YES | NO | TRUE | N/A
Internal | SIG-1 | AVAILABLE | N/A | AVAILABLE | BOOL | FLAG | 0x3010 | 12304 | 012305 | LAMP | REMOVE | 1 | %MX1.0 | N/A | N/A | N/A | N/A | NO | axSIG[] | YES | N/A | TRUE | N/A
Internal | SIG-2 | AVAILABLE | N/A | AVAILABLE | BOOL | FLAG | 0x3011 | 12305 | 012306 | LAMP | REMOVE | 1 | %MX1.1 | N/A | N/A | N/A | N/A | NO | axSIG[] | YES | N/A | TRUE | N/A
Internal | SIG-3 | AVAILABLE | N/A | AVAILABLE | BOOL | FLAG | 0x3012 | 12306 | 012307 | LAMP | REMOVE | 1 | %MX1.2 | N/A | N/A | N/A | N/A | NO | axSIG[] | YES | N/A | TRUE | N/A
Internal | SIG-4 | AVAILABLE | N/A | AVAILABLE | BOOL | FLAG | 0x3013 | 12307 | 012308 | LAMP | REMOVE | 1 | %MX1.3 | N/A | N/A | N/A | N/A | NO | axSIG[] | YES | N/A | TRUE | N/A
Internal | SIG-5 | Measured_Pump_Power | PUMP | IN-USE | REAL | FLAG | 0x310C | 12556 | 412557 | NUMERIC | WordAddress | 32 | %MD134 | N/A | N/A | N/A | N/A | NO | arSW[] | YES | N/A | TRUE | TRUE
Internal | SIG-6 | AVAILABLE | N/A | AVAILABLE | REAL | FLAG | 0x310E | 12558 | 412559 | NUMERIC | REMOVE | 32 | %MD135 | N/A | N/A | N/A | N/A | NO | arSW[] | YES | N/A | TRUE | N/A
Internal | SIG-7 | Measured_Conductivity | CONDUCTIVITY | IN-USE | REAL | FLAG | 0x3110 | 12560 | 412561 | NUMERIC | WordAddress | 32 | %MD136 | N/A | N/A | N/A | N/A | NO | arSW[] | YES | N/A | TRUE | TRUE
Internal | SIG-8 | Measured_Flow | FLOW | IN-USE | REAL | FLAG | 0x3112 | 12562 | 412563 | NUMERIC | WordAddress | 32 | %MD137 | N/A | N/A | N/A | N/A | NO | arSW[] | YES | N/A | TRUE | TRUE
Internal | SIG-9 | Valve_Position_Input | VALVE | IN-USE | REAL | FLAG | 0x3114 | 12564 | 412565 | NUMERIC | WordAddress | 32 | %MD138 | N/A | N/A | N/A | N/A | NO | arSW[] | YES | N/A | TRUE | TRUE
Internal | SIG-10 | Real_RTD_1_Signal | RTD | IN-USE | REAL | FLAG | 0x3116 | 12566 | 412567 | NUMERIC | WordAddress | 32 | %MD139 | N/A | N/A | N/A | N/A | NO | arSW[] | NO | N/A | TRUE | TRUE
Internal | SIG-11 | Real_RTD_2_Signal | RTD | IN-USE | REAL | FLAG | 0x3118 | 12568 | 412569 | NUMERIC | WordAddress | 32 | %MD140 | N/A | N/A | N/A | N/A | NO | arSW[] | NO | N/A | TRUE | TRUE
Internal | SIG-12 | Real_RTD_3_Signal | RTD | IN-USE | REAL | FLAG | 0x311A | 12570 | 412571 | NUMERIC | WordAddress | 32 | %MD141 | N/A | N/A | N/A | N/A | NO | arSW[] | NO | N/A | TRUE | TRUE
Internal | SIG-13 | AVAILABLE | N/A | AVAILABLE | REAL | FLAG | 0x311C | 12572 | 412573 | NUMERIC | REMOVE | 32 | %MD142 | N/A | N/A | N/A | N/A | NO | arSW[] | YES | N/A | TRUE | N/A
Internal | SIG-14 | Feedback_Valve_Position | VALVE | IN-USE | REAL | FLAG | 0x311E | 12574 | 412575 | NUMERIC | WordAddress | 32 | %MD143 | N/A | N/A | N/A | N/A | NO | arSW[] | YES | N/A | TRUE | TRUE
Internal | SIG-15 | AVAILABLE | N/A | AVAILABLE | BOOL | FLAG | 0x3014 | 12308 | 012309 | N/A | REMOVE | 1 | %MX1.4 | N/A | N/A | N/A | N/A | NO | axSIG[] | NO | N/A | TRUE | N/A
Internal | SIG-16 | AVAILABLE | N/A | AVAILABLE | BOOL | FLAG | 0x3015 | 12309 | 012310 | N/A | REMOVE | 1 | %MX1.5 | N/A | N/A | N/A | N/A | NO | axSIG[] | NO | N/A | TRUE | N/A
Internal | SIG-17 | AVAILABLE | N/A | AVAILABLE | BOOL | FLAG | 0x3016 | 12310 | 012311 | N/A | REMOVE | 1 | %MX1.6 | N/A | N/A | N/A | N/A | NO | axSIG[] | NO | N/A | TRUE | N/A
Internal | SIG-18 | AVAILABLE | N/A | AVAILABLE | BOOL | FLAG | 0x3017 | 12311 | 012312 | N/A | REMOVE | 1 | %MX1.7 | N/A | N/A | N/A | N/A | NO | axSIG[] | NO | N/A | TRUE | N/A
Internal | SIG-19 | AVAILABLE | N/A | AVAILABLE | BOOL | FLAG | 0x3018 | 12312 | 012313 | N/A | REMOVE | 1 | %MX1.8 | N/A | N/A | N/A | N/A | NO | axSIG[] | NO | N/A | TRUE | N/A
Internal | SIG-20 | AVAILABLE | N/A | AVAILABLE | BOOL | FLAG | 0x3019 | 12313 | 012314 | LAMP | REMOVE | 1 | %MX1.9 | N/A | N/A | N/A | N/A | NO | axSIG[] | YES | N/A | TRUE | N/A
Internal | SIG-21 | AVAILABLE | N/A | AVAILABLE | BOOL | FLAG | 0x301A | 12314 | 012315 | LAMP | REMOVE | 1 | %MX1.10 | N/A | N/A | N/A | N/A | NO | axSIG[] | YES | N/A | TRUE | N/A
Internal | SIG-22 | AVAILABLE | N/A | AVAILABLE | BOOL | FLAG | 0x301B | 12315 | 012316 | LAMP | REMOVE | 1 | %MX1.11 | N/A | N/A | N/A | N/A | NO | axSIG[] | YES | N/A | TRUE | N/A
Internal | SIG-23 | AVAILABLE | N/A | AVAILABLE | BOOL | FLAG | 0x301C | 12316 | 012317 | LAMP | REMOVE | 1 | %MX1.12 | N/A | N/A | N/A | N/A | NO | axSIG[] | YES | N/A | TRUE | N/A
Internal | SIG-24 | AVAILABLE | N/A | AVAILABLE | BOOL | FLAG | 0x301D | 12317 | 012318 | LAMP | REMOVE | 1 | %MX1.13 | N/A | N/A | N/A | N/A | NO | axSIG[] | YES | N/A | TRUE | N/A
Internal | SIG-25 | AVAILABLE | N/A | AVAILABLE | DINT | FLAG | 0x30A4 | 12452 | 012453 | N/A | REMOVE | 32 | %MD82 | N/A | N/A | N/A | N/A | NO | adiSW[] | NO | N/A | TRUE | N/A
Internal | SIG-26 | AVAILABLE | N/A | AVAILABLE | BOOL | FLAG | 0x301E | 12318 | 012319 | N/A | REMOVE | 1 | %MX1.14 | N/A | N/A | N/A | N/A | NO | axSIG[] | NO | N/A | TRUE | N/A
Internal | SIG-27 | Measured_Active_Pump__Voltage | PUMP | IN-USE | REAL | FLAG | 0x3120 | 12576 | 412577 | NUMERIC | WordAddress | 32 | %MD144 | N/A | N/A | N/A | N/A | NO | arSW[] | YES | N/A | TRUE | TRUE
Internal | SIG-28 | Measured_Active_Pump__Current | PUMP | IN-USE | REAL | FLAG | 0x3122 | 12578 | 412579 | NUMERIC | WordAddress | 32 | %MD145 | N/A | N/A | N/A | N/A | NO | arSW[] | YES | N/A | TRUE | TRUE
Internal | SIG-29 | AVAILABLE | N/A | AVAILABLE | REAL | FLAG | 0x3124 | 12580 | 412581 | NUMERIC | REMOVE | 32 | %MD146 | N/A | N/A | N/A | N/A | NO | arSW[] | YES | N/A | TRUE | N/A
Internal | SIG-30 | AVAILABLE | N/A | AVAILABLE | REAL | FLAG | 0x3126 | 12582 | 412583 | N/A | REMOVE | 32 | %MD147 | N/A | N/A | N/A | N/A | NO | arSW[] | YES | N/A | TRUE | N/A
Internal | SIG-31 | Pump_1_Total_Hours | PUMP | IN-USE | DINT | FLAG | 0x30A6 | 12454 | 412455 | NUMERIC | WordAddress | 32 | %MD83 | N/A | N/A | N/A | N/A | NO | adiSW[] | YES | N/A | TRUE | TRUE
Internal | SIG-32 | Pump_2_Total_Hours | PUMP | IN-USE | DINT | FLAG | 0x30A8 | 12456 | 412457 | NUMERIC | WordAddress | 32 | %MD84 | N/A | N/A | N/A | N/A | NO | adiSW[] | YES | N/A | TRUE | TRUE
Alarm | ALM-1 | High_Coolant_Temperature_ | RTD | IN-USE | BOOL | FLAG | 0x301F | 12319 | 012320 | LAMP | BitAddress | 1 | %MX1.15 | N/A | N/A | N/A | N/A | NO | axALM[] | YES | N/A | TRUE | TRUE
Alarm | ALM-2 | Low_Coolant_Level_in_Vessel | LEVEL | IN-USE | BOOL | FLAG | 0x3020 | 12320 | 012321 | LAMP | BitAddress | 1 | %MX2.0 | N/A | N/A | N/A | N/A | NO | axALM[] | YES | N/A | TRUE | TRUE
Alarm | ALM-3 | High_Coolant_Conductivity_ | CONDUCTIVITY | IN-USE | BOOL | FLAG | 0x3021 | 12321 | 012322 | LAMP | BitAddress | 1 | %MX2.1 | N/A | N/A | N/A | N/A | NO | axALM[] | YES | N/A | TRUE | TRUE
Alarm | ALM-4 | Low_Hydraulic_Power | PUMP | IN-USE | BOOL | FLAG | 0x3022 | 12322 | 012323 | LAMP | BitAddress | 1 | %MX2.2 | N/A | N/A | N/A | N/A | NO | axALM[] | YES | N/A | TRUE | TRUE
Alarm | ALM-5 | Low_Hydraulic_Flow | FLOW | IN-USE | BOOL | FLAG | 0x3023 | 12323 | 012324 | LAMP | BitAddress | 1 | %MX2.3 | N/A | N/A | N/A | N/A | NO | axALM[] | YES | N/A | TRUE | TRUE
Alarm | ALM-6 | Low_Hydraulic_Pressure | PRESSURE | IN-USE | BOOL | FLAG | 0x3024 | 12324 | 012325 | LAMP | BitAddress | 1 | %MX2.4 | N/A | N/A | N/A | N/A | NO | axALM[] | YES | N/A | TRUE | TRUE
Alarm | ALM-7 | Voltage_Signal_Malfunction | PUMP | IN-USE | BOOL | FLAG | 0x3025 | 12325 | 012326 | LAMP | BitAddress | 1 | %MX2.5 | N/A | N/A | N/A | N/A | NO | axALM[] | YES | N/A | TRUE | TRUE
Alarm | ALM-8 | Current_Signal_Malfunction | PUMP | IN-USE | BOOL | FLAG | 0x3026 | 12326 | 012327 | LAMP | BitAddress | 1 | %MX2.6 | N/A | N/A | N/A | N/A | NO | axALM[] | YES | N/A | TRUE | TRUE
Alarm | ALM-9 | Primary_Hydraulic_Failure | PUMP, FLOW, PRESSURE | IN-USE | BOOL | FLAG | 0x3027 | 12327 | 012328 | LAMP | BitAddress | 1 | %MX2.7 | N/A | N/A | N/A | N/A | NO | axALM[] | YES | N/A | TRUE | TRUE
Alarm | ALM-10 | Secondary_Hydraulic_Failure | PUMP, FLOW, PRESSURE | IN-USE | BOOL | FLAG | 0x3028 | 12328 | 012329 | LAMP | BitAddress | 1 | %MX2.8 | N/A | N/A | N/A | N/A | NO | axALM[] | YES | N/A | TRUE | TRUE
Alarm | ALM-11 | Automatic_Valve_Control_Disabled | VALVE | IN-USE | BOOL | FLAG | 0x3029 | 12329 | 012330 | LAMP | BitAddress | 1 | %MX2.9 | N/A | N/A | N/A | N/A | NO | axALM[] | YES | N/A | TRUE | TRUE
Alarm | ALM-12 | Regulation_Warning | FAN | IN-USE | BOOL | FLAG | 0x302A | 12330 | 012331 | LAMP | BitAddress | 1 | %MX2.10 | N/A | N/A | N/A | N/A | NO | axALM[] | YES | N/A | TRUE | TRUE
Alarm | ALM-13 | Flow_Signal_Malfunction | FLOW | IN-USE | BOOL | FLAG | 0x302B | 12331 | 012332 | LAMP | BitAddress | 1 | %MX2.11 | N/A | N/A | N/A | N/A | NO | axALM[] | YES | N/A | TRUE | TRUE
Alarm | ALM-14 | Bad_RTD_1_Signal | RTD | IN-USE | BOOL | FLAG | 0x302C | 12332 | 012333 | LAMP | BitAddress | 1 | %MX2.12 | N/A | N/A | N/A | N/A | NO | axALM[] | YES | N/A | TRUE | TRUE
Alarm | ALM-15 | Bad_RTD_2_Signal | RTD | IN-USE | BOOL | FLAG | 0x302D | 12333 | 012334 | LAMP | BitAddress | 1 | %MX2.13 | N/A | N/A | N/A | N/A | NO | axALM[] | YES | N/A | TRUE | TRUE
Alarm | ALM-16 | Bad_RTD_3_Signal | RTD | IN-USE | BOOL | FLAG | 0x302E | 12334 | 012335 | LAMP | BitAddress | 1 | %MX2.14 | N/A | N/A | N/A | N/A | NO | axALM[] | YES | N/A | TRUE | TRUE
Alarm | ALM-17 | Pump_Cycle_Alarm | PUMP | IN-USE | BOOL | FLAG | 0x302F | 12335 | 012336 | LAMP | BitAddress | 1 | %MX2.15 | N/A | N/A | N/A | N/A | NO | axALM[] | YES | N/A | TRUE | TRUE
Fault | FLT-1 | Critical_Temperature | RTD | IN-USE | BOOL | FLAG | 0x3030 | 12336 | 012337 | LAMP | BitAddress | 1 | %MX3.0 | N/A | N/A | N/A | N/A | NO | axFLT[] | YES | N/A | TRUE | TRUE
Fault | FLT-2 | Critical_Vessel_Level | LEVEL | IN-USE | BOOL | FLAG | 0x3031 | 12337 | 012338 | LAMP | BitAddress | 1 | %MX3.1 | N/A | N/A | N/A | N/A | NO | axFLT[] | YES | N/A | TRUE | TRUE
Fault | FLT-3 | Critical_Conductivity | CONDUCTIVITY | IN-USE | BOOL | FLAG | 0x3032 | 12338 | 012339 | LAMP | BitAddress | 1 | %MX3.2 | N/A | N/A | N/A | N/A | NO | axFLT[] | YES | N/A | TRUE | TRUE
Fault | FLT-4 | Level_Sensor_Malfunction | LEVEL | IN-USE | BOOL | FLAG | 0x3033 | 12339 | 012340 | LAMP | BitAddress | 1 | %MX3.3 | N/A | N/A | N/A | N/A | NO | axFLT[] | YES | N/A | TRUE | TRUE
Fault | FLT-5 | Conductivity_Sensor_Malfunction | CONDUCTIVITY | IN-USE | BOOL | FLAG | 0x3034 | 12340 | 012341 | LAMP | BitAddress | 1 | %MX3.4 | N/A | N/A | N/A | N/A | NO | axFLT[] | YES | N/A | TRUE | TRUE
Fault | FLT-6 | Bingo_Pumps | PUMP | IN-USE | BOOL | FLAG | 0x3035 | 12341 | 012342 | LAMP | BitAddress | 1 | %MX3.5 | N/A | N/A | N/A | N/A | NO | axFLT[] | YES | N/A | TRUE | TRUE
Fault | FLT-7 | Temperature_Sensor_Malfunction | RTD | IN-USE | BOOL | FLAG | 0x3036 | 12342 | 012343 | LAMP | BitAddress | 1 | %MX3.6 | N/A | N/A | N/A | N/A | NO | axFLT[] | YES | N/A | TRUE | TRUE
Fault | FLT-8 | Bad_Valve_Pos | VALVE | IN-USE | BOOL | FLAG | 0x3037 | 12343 | 012344 | LAMP | BitAddress | 1 | %MX3.7 | N/A | N/A | N/A | N/A | NO | axFLT[] | YES | N/A | TRUE | TRUE
Fault | FLT-9 | Master_Fault_Signal | SYSTEM | IN-USE | BOOL | FLAG | 0x3038 | 12344 | 012345 | LAMP | BitAddress | 1 | %MX3.8 | N/A | N/A | N/A | N/A | NO | axFLT[] | YES | N/A | TRUE | TRUE
Physical | PHY-1 | Conductivity_Analog | CONDUCTIVITY | IN-USE | WORD | INTERNAL I/O | NOT ACCESSIBLE | NOT ACCESSIBLE | NOT ACCESSIBLE | N/A | REMOVE | 16 | %IW0 | 8 | 750-492 | 1 | INPUT | YES | wrFlow | NO | N/A | TRUE | TRUE
Physical | PHY-2 | RTD_1 | RTD | IN-USE | INT | INTERNAL I/O | NOT ACCESSIBLE | NOT ACCESSIBLE | NOT ACCESSIBLE | N/A | REMOVE | 16 | %IW2 | 9 | 750-461 | 1 | INPUT | YES | wrRTD1 | NO | N/A | TRUE | TRUE
Physical | PHY-3 | RTD_2 | RTD | IN-USE | INT | INTERNAL I/O | NOT ACCESSIBLE | NOT ACCESSIBLE | NOT ACCESSIBLE | N/A | REMOVE | 16 | %IW3 | 9 | 750-461 | 2 | INPUT | YES | wrRTD2 | NO | N/A | TRUE | TRUE
Physical | PHY-4 | RTD_3 | RTD | IN-USE | INT | INTERNAL I/O | NOT ACCESSIBLE | NOT ACCESSIBLE | NOT ACCESSIBLE | N/A | REMOVE | 16 | %IW4 | 10 | 750-461 | 1 | INPUT | YES | wrRTD3 | NO | N/A | TRUE | TRUE
Physical | PHY-5 | AVAILABLE |  | AVAILABLE | WORD | INTERNAL I/O | NOT ACCESSIBLE | NOT ACCESSIBLE | NOT ACCESSIBLE | N/A | REMOVE | 16 |  |  |  |  | INPUT | YES |  | NO | N/A | TRUE | N/A
Physical | PHY-6 | AVAILABLE |  | AVAILABLE | WORD | INTERNAL I/O | NOT ACCESSIBLE | NOT ACCESSIBLE | NOT ACCESSIBLE | N/A | REMOVE | 16 |  |  |  |  | INPUT | YES |  | NO | N/A | TRUE | N/A
Physical | PHY-7 | Flow_Analog | FLOW | IN-USE | WORD | INTERNAL I/O | NOT ACCESSIBLE | NOT ACCESSIBLE | NOT ACCESSIBLE | N/A | REMOVE | 16 | %IW1 | 8 | 750-492 | 2 | INPUT | YES | wrConductivity | NO | N/A | TRUE | TRUE
Physical | PHY-8 | Conductivity_Alarm | CONDUCTIVITY | IN-USE | BOOL | INTERNAL I/O | NOT ACCESSIBLE | NOT ACCESSIBLE | NOT ACCESSIBLE | N/A | REMOVE | 1 | %IX10.2 | 2 | 750-403 | 1 | INPUT | YES | xrCondAlm | NO | N/A | TRUE | FALSE
Physical | PHY-9 | Conductivity_Fault | CONDUCTIVITY | IN-USE | BOOL | INTERNAL I/O | NOT ACCESSIBLE | NOT ACCESSIBLE | NOT ACCESSIBLE | N/A | REMOVE | 1 | %IX10.3 | 2 | 750-403 | 2 | INPUT | YES | xrCondFlt | NO | N/A | TRUE | FALSE
Physical | PHY-10 | Level_Low_Switch | LEVEL | IN-USE | BOOL | INTERNAL I/O | NOT ACCESSIBLE | NOT ACCESSIBLE | NOT ACCESSIBLE | N/A | REMOVE | 1 | %IX10.0 | 1 | 750-400 | 1 | INPUT | YES | xrWaterLow | NO | N/A | TRUE | TRUE
Physical | PHY-11 | Level_Low_Low_Switch | LEVEL | IN-USE | BOOL | INTERNAL I/O | NOT ACCESSIBLE | NOT ACCESSIBLE | NOT ACCESSIBLE | N/A | REMOVE | 1 | %IX10.1 | 1 | 750-400 | 2 | INPUT | YES | xrWaterLowLow | NO | N/A | TRUE | TRUE
Physical | PHY-12 | Fan_1_Enable | FAN | IN-USE | BOOL | INTERNAL I/O | NOT ACCESSIBLE | NOT ACCESSIBLE | NOT ACCESSIBLE | N/A | REMOVE | 1 | %QX2.1 | 5 | 750-530 | 2 | OUTPUT | YES | xrFan1Active | NO | N/A | TRUE | TRUE
Physical | PHY-13 | Fan_2_Enable | FAN | IN-USE | BOOL | INTERNAL I/O | NOT ACCESSIBLE | NOT ACCESSIBLE | NOT ACCESSIBLE | N/A | REMOVE | 1 | %QX2.3 | 5 | 750-530 | 4 | OUTPUT | YES | xrFan2Active | NO | N/A | TRUE | TRUE
Physical | PHY-14 | Pump_1_Enable | PUMP | IN-USE | BOOL | INTERNAL I/O | NOT ACCESSIBLE | NOT ACCESSIBLE | NOT ACCESSIBLE | N/A | REMOVE | 1 | %QX2.0 | 5 | 750-530 | 1 | OUTPUT | YES | xrPump1Active | NO | N/A | TRUE | TRUE
Physical | PHY-15 | Pump_2_Enable | PUMP | IN-USE | BOOL | INTERNAL I/O | NOT ACCESSIBLE | NOT ACCESSIBLE | NOT ACCESSIBLE | N/A | REMOVE | 1 | %QX2.2 | 5 | 750-530 | 3 | OUTPUT | YES | xrPump2Active | NO | N/A | TRUE | TRUE
Physical | PHY-16 | Valve_Actuation_Signal | VALVE | IN-USE | WORD | INTERNAL I/O | NOT ACCESSIBLE | NOT ACCESSIBLE | NOT ACCESSIBLE | N/A | REMOVE | 16 | %QW0 | 12 | 750-554 | 1 | OUTPUT | YES | wrAct | NO | N/A | TRUE | TRUE
Physical | PHY-17 | Pressure_Switch_Signal | PRESSURE | IN-USE | BOOL | INTERNAL I/O | NOT ACCESSIBLE | NOT ACCESSIBLE | NOT ACCESSIBLE | N/A | REMOVE | 1 | %IX10.4 | 2 | 750-403 | 3 | INPUT | YES | xrPress | NO | N/A | TRUE | FALSE
Physical | PHY-18 | Active_Pump__Current | PUMP | IN-USE | WORD | INTERNAL I/O | NOT ACCESSIBLE | NOT ACCESSIBLE | NOT ACCESSIBLE | N/A | REMOVE | 16 | %IW6 | 11 | 750-455 | 1 | INPUT | YES | wrCurrent | NO | N/A | TRUE | TRUE
Physical | PHY-19 | Active_Pump__Voltage | PUMP | IN-USE | WORD | INTERNAL I/O | NOT ACCESSIBLE | NOT ACCESSIBLE | NOT ACCESSIBLE | N/A | REMOVE | 16 | %IW7 | 11 | 750-455 | 2 | INPUT | YES | wrVoltage | NO | N/A | TRUE | TRUE
Physical | PHY-20 | Valve_Feedback_Signal | VALVE | IN-USE | WORD | INTERNAL I/O | NOT ACCESSIBLE | NOT ACCESSIBLE | NOT ACCESSIBLE | N/A | REMOVE | 16 | %IW8 | 11 | 750-455 | 3 | INPUT | YES | wrValvePos | NO | N/A | TRUE | TRUE
Physical | PHY-21 | AVAILABLE |  | AVAILABLE | WORD | INTERNAL I/O | NOT ACCESSIBLE | NOT ACCESSIBLE | NOT ACCESSIBLE | N/A | REMOVE | 16 | %IW9 | 11 | 750-455 | 4 | INPUT | YES |  | NO | N/A | TRUE | N/A
Internal | SIG-33 | Primary_Pump_Active | PUMP | IN-USE | BOOL | FLAG | 0x3039 | 12345 | 012346 | LAMP | BitAddress | 1 | %MX3.9 | N/A | N/A | N/A | N/A | NO |  | YES | N/A | TRUE | TRUE
Internal | SIG-34 | Secondary_Pump__Active | PUMP | IN-USE | BOOL | FLAG | 0x303A | 12346 | 012347 | LAMP | BitAddress | 1 | %MX3.10 | N/A | N/A | N/A | N/A | NO |  | YES | N/A | TRUE | TRUE
Internal | SIG-35 | Simplex_Mode_Active | PUMP | IN-USE | BOOL | FLAG | 0x303B | 12347 | 012348 | LAMP | BitAddress | 1 | %MX3.11 | N/A | N/A | N/A | N?A | NO |  | YES | N/A | TRUE | TRUE
Internal | SIG-36 | Fan_1_Active | FAN | IN-USE | BOOL | FLAG | 0x303C | 12348 | 012349 | LAMP | BitAddress | 1 | %MX3.12 | N/A | N/A | N/A | N/A | NO |  | YES | N/A | TRUE | TRUE
Internal | SIG-37 | Fan_2_Active | FAN | IN-USE | BOOL | FLAG | 0x303D | 12349 | 012350 | LAMP | BitAddress | 1 | %MX3.13 | N/A | N/A | N/A | N/A | NO |  | YES | N/A | TRUE | TRUE
Internal | SIG-38 | Pump_Cycle_Enabled | PUMP | IN-USE | BOOL | FLAG | 0x303E | 12350 | 012351 | LAMP | BitAddress | 1 | %MX3.14 | N/A | N/A | N/A | N/A | NO |  | YES |  | TRUE | TRUE
Internal | SIG-39 | System_Diagnostics | SYSTEM | IN-USE | BOOL | FLAG | 0x303F | 12351 | 012352 | LAMP | BitAddress | 1 | %MX3.15 | N/A | N/A | N/A | N/A | NO |  | YES |  | TRUE | TRUE
Internal | SIG-40 | Status_Indicator_Text | SYSTEM | IN-USE | STRING | FLAG | 0x318A | 12682 | 412683 | TEXT | WordAddress | 32 | %MD197 | N/A | N/A | N/A | N/A | NO | sStatus | YES |  | TRUE | TRUE
Internal | SIG-41 | Mode_Indicator_Text | SYSTEM | IN-USE | STRING | FLAG | 0x31EE | 12782 | 412783 | TEXT | WordAddress | 32 | %MD247 | N?A |  |  |  |  |  | YES |  | FALSE | FALSE

Sheet: Symbol Table
GP-Pro EX |  |  |  |  |  |  | "GP-Pro EX"
File Type | SymbolVariable |  |  |  |  |  | "File Type","SymbolVariable"
File Version | 3 | 0 |  |  |  |  | "File Version","3","0"
Name | Index | Type | Internal/External | Address | Keep | Comment | "Name","Index","Type","Internal/External","Address","Keep","Comment"
System_Start |  | BitAddress | PLC1 | 012289 |  |  | System_Start,,BitAddress,PLC1,012289,,
System_Shutdown |  | BitAddress | PLC1 | 012290 |  |  | System_Shutdown,,BitAddress,PLC1,012290,,
Simplex_Mode |  | BitAddress | PLC1 | 012291 |  |  | Simplex_Mode,,BitAddress,PLC1,012291,,
Manual_Turnover |  | BitAddress | PLC1 | 012292 |  |  | Manual_Turnover,,BitAddress,PLC1,012292,,
Enable_Manual_Valve_Control |  | BitAddress | PLC1 | 012293 |  |  | Enable_Manual_Valve_Control,,BitAddress,PLC1,012293,,
Enable_Manual_Fan_Control |  | BitAddress | PLC1 | 012294 |  |  | Enable_Manual_Fan_Control,,BitAddress,PLC1,012294,,
Update_Setpoint |  | BitAddress | PLC1 | 012295 |  |  | Update_Setpoint,,BitAddress,PLC1,012295,,
Force_Fan_1_On_Off |  | BitAddress | PLC1 | 012296 |  |  | Force_Fan_1_On_Off,,BitAddress,PLC1,012296,,
Force_Fan_2_On_Off |  | BitAddress | PLC1 | 012297 |  |  | Force_Fan_2_On_Off,,BitAddress,PLC1,012297,,
Engage_Backup_Fans |  | BitAddress | PLC1 | 012298 |  |  | Engage_Backup_Fans,,BitAddress,PLC1,012298,,
AVAILABLE |  | REMOVE | PLC1 | 012299 |  |  | AVAILABLE,,REMOVE,PLC1,012299,,
Enable_Pump_Cycling |  | BitAddress | PLC1 | 012300 |  |  | Enable_Pump_Cycling,,BitAddress,PLC1,012300,,
Reset_Pump_Differential_Signal |  | BitAddress | PLC1 | 012301 |  |  | Reset_Pump_Differential_Signal,,BitAddress,PLC1,012301,,
Fault_Override |  | BitAddress | PLC1 | 012302 |  |  | Fault_Override,,BitAddress,PLC1,012302,,
AVAILABLE |  | REMOVE | PLC1 | 012303 |  |  | AVAILABLE,,REMOVE,PLC1,012303,,
AVAILABLE |  | REMOVE | PLC1 | 012304 |  |  | AVAILABLE,,REMOVE,PLC1,012304,,
AVAILABLE |  | REMOVE | PLC1 | 012305 |  |  | AVAILABLE,,REMOVE,PLC1,012305,,
AVAILABLE |  | REMOVE | PLC1 | 012306 |  |  | AVAILABLE,,REMOVE,PLC1,012306,,
AVAILABLE |  | REMOVE | PLC1 | 012307 |  |  | AVAILABLE,,REMOVE,PLC1,012307,,
AVAILABLE |  | REMOVE | PLC1 | 012308 |  |  | AVAILABLE,,REMOVE,PLC1,012308,,
Measured_Pump_Power |  | WordAddress | PLC1 | 412557 |  |  | Measured_Pump_Power,,WordAddress,PLC1,412557,,
AVAILABLE |  | REMOVE | PLC1 | 412559 |  |  | AVAILABLE,,REMOVE,PLC1,412559,,
Measured_Conductivity |  | WordAddress | PLC1 | 412561 |  |  | Measured_Conductivity,,WordAddress,PLC1,412561,,
Measured_Flow |  | WordAddress | PLC1 | 412563 |  |  | Measured_Flow,,WordAddress,PLC1,412563,,
Valve_Position_Input |  | WordAddress | PLC1 | 412565 |  |  | Valve_Position_Input,,WordAddress,PLC1,412565,,
Real_RTD_1_Signal |  | WordAddress | PLC1 | 412567 |  |  | Real_RTD_1_Signal,,WordAddress,PLC1,412567,,
Real_RTD_2_Signal |  | WordAddress | PLC1 | 412569 |  |  | Real_RTD_2_Signal,,WordAddress,PLC1,412569,,
Real_RTD_3_Signal |  | WordAddress | PLC1 | 412571 |  |  | Real_RTD_3_Signal,,WordAddress,PLC1,412571,,
AVAILABLE |  | REMOVE | PLC1 | 412573 |  |  | AVAILABLE,,REMOVE,PLC1,412573,,
Feedback_Valve_Position |  | WordAddress | PLC1 | 412575 |  |  | Feedback_Valve_Position,,WordAddress,PLC1,412575,,
AVAILABLE |  | REMOVE | PLC1 | 012309 |  |  | AVAILABLE,,REMOVE,PLC1,012309,,
AVAILABLE |  | REMOVE | PLC1 | 012310 |  |  | AVAILABLE,,REMOVE,PLC1,012310,,
AVAILABLE |  | REMOVE | PLC1 | 012311 |  |  | AVAILABLE,,REMOVE,PLC1,012311,,
AVAILABLE |  | REMOVE | PLC1 | 012312 |  |  | AVAILABLE,,REMOVE,PLC1,012312,,
AVAILABLE |  | REMOVE | PLC1 | 012313 |  |  | AVAILABLE,,REMOVE,PLC1,012313,,
AVAILABLE |  | REMOVE | PLC1 | 012314 |  |  | AVAILABLE,,REMOVE,PLC1,012314,,
AVAILABLE |  | REMOVE | PLC1 | 012315 |  |  | AVAILABLE,,REMOVE,PLC1,012315,,
AVAILABLE |  | REMOVE | PLC1 | 012316 |  |  | AVAILABLE,,REMOVE,PLC1,012316,,
AVAILABLE |  | REMOVE | PLC1 | 012317 |  |  | AVAILABLE,,REMOVE,PLC1,012317,,
AVAILABLE |  | REMOVE | PLC1 | 012318 |  |  | AVAILABLE,,REMOVE,PLC1,012318,,
AVAILABLE |  | REMOVE | PLC1 | 012453 |  |  | AVAILABLE,,REMOVE,PLC1,012453,,
AVAILABLE |  | REMOVE | PLC1 | 012319 |  |  | AVAILABLE,,REMOVE,PLC1,012319,,
Measured_Active_Pump__Voltage |  | WordAddress | PLC1 | 412577 |  |  | Measured_Active_Pump__Voltage,,WordAddress,PLC1,412577,,
Measured_Active_Pump__Current |  | WordAddress | PLC1 | 412579 |  |  | Measured_Active_Pump__Current,,WordAddress,PLC1,412579,,
AVAILABLE |  | REMOVE | PLC1 | 412581 |  |  | AVAILABLE,,REMOVE,PLC1,412581,,
AVAILABLE |  | REMOVE | PLC1 | 412583 |  |  | AVAILABLE,,REMOVE,PLC1,412583,,
Pump_1_Total_Hours |  | WordAddress | PLC1 | 412455 |  |  | Pump_1_Total_Hours,,WordAddress,PLC1,412455,,
Pump_2_Total_Hours |  | WordAddress | PLC1 | 412457 |  |  | Pump_2_Total_Hours,,WordAddress,PLC1,412457,,
High_Coolant_Temperature_ |  | BitAddress | PLC1 | 012320 |  |  | High_Coolant_Temperature_,,BitAddress,PLC1,012320,,
Low_Coolant_Level_in_Vessel |  | BitAddress | PLC1 | 012321 |  |  | Low_Coolant_Level_in_Vessel,,BitAddress,PLC1,012321,,
High_Coolant_Conductivity_ |  | BitAddress | PLC1 | 012322 |  |  | High_Coolant_Conductivity_,,BitAddress,PLC1,012322,,
Low_Hydraulic_Power |  | BitAddress | PLC1 | 012323 |  |  | Low_Hydraulic_Power,,BitAddress,PLC1,012323,,
Low_Hydraulic_Flow |  | BitAddress | PLC1 | 012324 |  |  | Low_Hydraulic_Flow,,BitAddress,PLC1,012324,,
Low_Hydraulic_Pressure |  | BitAddress | PLC1 | 012325 |  |  | Low_Hydraulic_Pressure,,BitAddress,PLC1,012325,,
Voltage_Signal_Malfunction |  | BitAddress | PLC1 | 012326 |  |  | Voltage_Signal_Malfunction,,BitAddress,PLC1,012326,,
Current_Signal_Malfunction |  | BitAddress | PLC1 | 012327 |  |  | Current_Signal_Malfunction,,BitAddress,PLC1,012327,,
Primary_Hydraulic_Failure |  | BitAddress | PLC1 | 012328 |  |  | Primary_Hydraulic_Failure,,BitAddress,PLC1,012328,,
Secondary_Hydraulic_Failure |  | BitAddress | PLC1 | 012329 |  |  | Secondary_Hydraulic_Failure,,BitAddress,PLC1,012329,,
Automatic_Valve_Control_Disabled |  | BitAddress | PLC1 | 012330 |  |  | Automatic_Valve_Control_Disabled,,BitAddress,PLC1,012330,,
Regulation_Warning |  | BitAddress | PLC1 | 012331 |  |  | Regulation_Warning,,BitAddress,PLC1,012331,,
Flow_Signal_Malfunction |  | BitAddress | PLC1 | 012332 |  |  | Flow_Signal_Malfunction,,BitAddress,PLC1,012332,,
Bad_RTD_1_Signal |  | BitAddress | PLC1 | 012333 |  |  | Bad_RTD_1_Signal,,BitAddress,PLC1,012333,,
Bad_RTD_2_Signal |  | BitAddress | PLC1 | 012334 |  |  | Bad_RTD_2_Signal,,BitAddress,PLC1,012334,,
Bad_RTD_3_Signal |  | BitAddress | PLC1 | 012335 |  |  | Bad_RTD_3_Signal,,BitAddress,PLC1,012335,,
Pump_Cycle_Alarm |  | BitAddress | PLC1 | 012336 |  |  | Pump_Cycle_Alarm,,BitAddress,PLC1,012336,,
Critical_Temperature |  | BitAddress | PLC1 | 012337 |  |  | Critical_Temperature,,BitAddress,PLC1,012337,,
Critical_Vessel_Level |  | BitAddress | PLC1 | 012338 |  |  | Critical_Vessel_Level,,BitAddress,PLC1,012338,,
Critical_Conductivity |  | BitAddress | PLC1 | 012339 |  |  | Critical_Conductivity,,BitAddress,PLC1,012339,,
Level_Sensor_Malfunction |  | BitAddress | PLC1 | 012340 |  |  | Level_Sensor_Malfunction,,BitAddress,PLC1,012340,,
Conductivity_Sensor_Malfunction |  | BitAddress | PLC1 | 012341 |  |  | Conductivity_Sensor_Malfunction,,BitAddress,PLC1,012341,,
Bingo_Pumps |  | BitAddress | PLC1 | 012342 |  |  | Bingo_Pumps,,BitAddress,PLC1,012342,,
Temperature_Sensor_Malfunction |  | BitAddress | PLC1 | 012343 |  |  | Temperature_Sensor_Malfunction,,BitAddress,PLC1,012343,,
Bad_Valve_Pos |  | BitAddress | PLC1 | 012344 |  |  | Bad_Valve_Pos,,BitAddress,PLC1,012344,,
Master_Fault_Signal |  | BitAddress | PLC1 | 012345 |  |  | Master_Fault_Signal,,BitAddress,PLC1,012345,,
Conductivity_Analog |  | REMOVE | PLC1 | NOT ACCESSIBLE |  |  | Conductivity_Analog,,REMOVE,PLC1,NOT ACCESSIBLE,,
RTD_1 |  | REMOVE | PLC1 | NOT ACCESSIBLE |  |  | RTD_1,,REMOVE,PLC1,NOT ACCESSIBLE,,
RTD_2 |  | REMOVE | PLC1 | NOT ACCESSIBLE |  |  | RTD_2,,REMOVE,PLC1,NOT ACCESSIBLE,,
RTD_3 |  | REMOVE | PLC1 | NOT ACCESSIBLE |  |  | RTD_3,,REMOVE,PLC1,NOT ACCESSIBLE,,
AVAILABLE |  | REMOVE | PLC1 | NOT ACCESSIBLE |  |  | AVAILABLE,,REMOVE,PLC1,NOT ACCESSIBLE,,
AVAILABLE |  | REMOVE | PLC1 | NOT ACCESSIBLE |  |  | AVAILABLE,,REMOVE,PLC1,NOT ACCESSIBLE,,
Flow_Analog |  | REMOVE | PLC1 | NOT ACCESSIBLE |  |  | Flow_Analog,,REMOVE,PLC1,NOT ACCESSIBLE,,
Conductivity_Alarm |  | REMOVE | PLC1 | NOT ACCESSIBLE |  |  | Conductivity_Alarm,,REMOVE,PLC1,NOT ACCESSIBLE,,
Conductivity_Fault |  | REMOVE | PLC1 | NOT ACCESSIBLE |  |  | Conductivity_Fault,,REMOVE,PLC1,NOT ACCESSIBLE,,
Level_Low_Switch |  | REMOVE | PLC1 | NOT ACCESSIBLE |  |  | Level_Low_Switch,,REMOVE,PLC1,NOT ACCESSIBLE,,
Level_Low_Low_Switch |  | REMOVE | PLC1 | NOT ACCESSIBLE |  |  | Level_Low_Low_Switch,,REMOVE,PLC1,NOT ACCESSIBLE,,
Fan_1_Enable |  | REMOVE | PLC1 | NOT ACCESSIBLE |  |  | Fan_1_Enable,,REMOVE,PLC1,NOT ACCESSIBLE,,
Fan_2_Enable |  | REMOVE | PLC1 | NOT ACCESSIBLE |  |  | Fan_2_Enable,,REMOVE,PLC1,NOT ACCESSIBLE,,
Pump_1_Enable |  | REMOVE | PLC1 | NOT ACCESSIBLE |  |  | Pump_1_Enable,,REMOVE,PLC1,NOT ACCESSIBLE,,
Pump_2_Enable |  | REMOVE | PLC1 | NOT ACCESSIBLE |  |  | Pump_2_Enable,,REMOVE,PLC1,NOT ACCESSIBLE,,
Valve_Actuation_Signal |  | REMOVE | PLC1 | NOT ACCESSIBLE |  |  | Valve_Actuation_Signal,,REMOVE,PLC1,NOT ACCESSIBLE,,
Pressure_Switch_Signal |  | REMOVE | PLC1 | NOT ACCESSIBLE |  |  | Pressure_Switch_Signal,,REMOVE,PLC1,NOT ACCESSIBLE,,
Active_Pump__Current |  | REMOVE | PLC1 | NOT ACCESSIBLE |  |  | Active_Pump__Current,,REMOVE,PLC1,NOT ACCESSIBLE,,
Active_Pump__Voltage |  | REMOVE | PLC1 | NOT ACCESSIBLE |  |  | Active_Pump__Voltage,,REMOVE,PLC1,NOT ACCESSIBLE,,
Valve_Feedback_Signal |  | REMOVE | PLC1 | NOT ACCESSIBLE |  |  | Valve_Feedback_Signal,,REMOVE,PLC1,NOT ACCESSIBLE,,
AVAILABLE |  | REMOVE | PLC1 | NOT ACCESSIBLE |  |  | AVAILABLE,,REMOVE,PLC1,NOT ACCESSIBLE,,
Primary_Pump_Active |  | BitAddress | PLC1 | 012346 |  |  | Primary_Pump_Active,,BitAddress,PLC1,012346,,
Secondary_Pump__Active |  | BitAddress | PLC1 | 012347 |  |  | Secondary_Pump__Active,,BitAddress,PLC1,012347,,
Simplex_Mode_Active |  | BitAddress | PLC1 | 012348 |  |  | Simplex_Mode_Active,,BitAddress,PLC1,012348,,
Fan_1_Active |  | BitAddress | PLC1 | 012349 |  |  | Fan_1_Active,,BitAddress,PLC1,012349,,
Fan_2_Active |  | BitAddress | PLC1 | 012350 |  |  | Fan_2_Active,,BitAddress,PLC1,012350,,
Pump_Cycle_Enabled |  | BitAddress | PLC1 | 012351 |  |  | Pump_Cycle_Enabled,,BitAddress,PLC1,012351,,
System_Diagnostics |  | BitAddress | PLC1 | 012352 |  |  | System_Diagnostics,,BitAddress,PLC1,012352,,
Status_Indicator_Text |  | WordAddress | PLC1 | 412683 |  |  | Status_Indicator_Text,,WordAddress,PLC1,412683,,
Mode_Indicator_Text |  | WordAddress | PLC1 | 412783
0 |  | 0 | PLC1 | 0
0 |  | 0 | PLC1 | 0
0 |  | 0 | PLC1 | 0
0 |  | 0 | PLC1 | 0
0 |  | 0 | PLC1 | 0
0 |  | 0 | PLC1 | 0
0 |  | 0 | PLC1 | 0
0 |  | 0 | PLC1 | 0
0 |  | 0 | PLC1 | 0
0 |  | 0 | PLC1 | 0
0 |  | 0 | PLC1 | 0
0 |  | 0 | PLC1 | 0
0 |  | 0 | PLC1 | 0
#REF! |  | 0 | PLC1 | 0
0 |  | 0 | PLC1 | 0
0 |  | 0 | PLC1 | 0
0 |  | 0 | PLC1 | 0
0 |  | 0 | PLC1 | 0
0 |  | 0 | PLC1 | 0
0 |  | 0 | PLC1 | 0
0 |  | 0 | PLC1 | 0
0 |  | 0 | PLC1 | 0
0 |  | 0 | PLC1 | 0
0 |  | 0 | PLC1 | 0
0 |  | 0 | PLC1 | 0
0 |  | 0 | PLC1 | 0
0 |  | 0 | PLC1 | 0
0 |  | 0 | PLC1 | 0
0 |  | 0 | PLC1 | 0
0 |  | 0 | PLC1 | 0
0 |  | 0 | PLC1 | 0
0 |  | 0 | PLC1 | 0
0 |  | 0 | PLC1 | 0
0 |  | 0 | PLC1 | 0
0 |  | 0 | PLC1 | 0
0 |  | 0 | PLC1 | 0
0 |  | 0 | PLC1 | 0
0 |  | 0 | PLC1 | 0
0 |  | 0 | PLC1 | 0
0 |  | 0 | PLC1 | 0
0 |  | 0 | PLC1 | 0
0 |  | 0 | PLC1 | 0
0 |  | 0 | PLC1 | 0
0 |  | 0 | PLC1 | 0
0 |  | 0 | PLC1 | 0
0 |  | 0 | PLC1 | 0
0 |  | 0 | PLC1 | 0
0 |  | 0 | PLC1 | 0
0 |  | 0 | PLC1 | 0
0 |  | 0 | PLC1 | 0
0 |  | 0 | PLC1 | 0
0 |  | 0 | PLC1 | 0
0 |  | 0 | PLC1 | 0
0 |  | 0 | PLC1 | 0
0 |  | 0 | PLC1 | 0
0 |  | 0 | PLC1 | 0
0 |  | 0 | PLC1 | 0
0 |  | 0 | PLC1 | 0
0 |  | 0 | PLC1 | 0
0 |  | 0 | PLC1 | 0
0 |  | 0 | PLC1 | 0
0 |  | 0 | PLC1 | 0
0 |  | 0 | PLC1 | 0
0 |  | 0 | PLC1 | 0
0 |  | 0 | PLC1 | 0
0 |  | 0 | PLC1 | 0
0 |  | 0 | PLC1 | 0
0 |  | 0 | PLC1 | 0
0 |  | 0 | PLC1 | 0
0 |  | 0 | PLC1 | 0
0 |  | 0 | PLC1 | 0
0 |  | 0 | PLC1 | 0
0 |  | 0 | PLC1 | 0
0 |  | 0 | PLC1 | 0
0 |  | 0 | PLC1 | 0
0 |  | 0 | PLC1 | 0
0 |  | 0 | PLC1 | 0
0 |  | 0 | PLC1 | 0
0 |  | 0 | PLC1 | 0
0 |  | 0 | PLC1 | 0
0 |  | 0 | PLC1 | 0
0 |  | 0 | PLC1 | 0
0 |  | 0 | PLC1 | 0
0 |  | 0 | PLC1 | 0
0 |  | 0 | PLC1 | 0

Sheet: Mapping Sheet
1 | 12288 | 12289 | 0x3000 | 0 | 0 | 0
2 | 12289 | 12290 | 0x3001 | 0 | 1
3 | 12290 | 12291 | 0x3002 | 0 | 2 | 1
4 | 12291 | 12292 | 0x3003 | 0 | 3
5 | 12292 | 12293 | 0x3004 | 0 | 4 | 2
6 | 12293 | 12294 | 0x3005 | 0 | 5
7 | 12294 | 12295 | 0x3006 | 0 | 6 | 3
8 | 12295 | 12296 | 0x3007 | 0 | 7
9 | 12296 | 12297 | 0x3008 | 0 | 8 | 4
10 | 12297 | 12298 | 0x3009 | 0 | 9
11 | 12298 | 12299 | 0x300A | 0 | 10 | 5
12 | 12299 | 12300 | 0x300B | 0 | 11
13 | 12300 | 12301 | 0x300C | 0 | 12 | 6
14 | 12301 | 12302 | 0x300D | 0 | 13
15 | 12302 | 12303 | 0x300E | 0 | 14 | 7
16 | 12303 | 12304 | 0x300F | 0 | 15
17 | 12304 | 12305 | 0x3010 | 1 | 0 | 8
18 | 12305 | 12306 | 0x3011 | 1 | 1
19 | 12306 | 12307 | 0x3012 | 1 | 2 | 9
20 | 12307 | 12308 | 0x3013 | 1 | 3
21 | 12308 | 12309 | 0x3014 | 1 | 4 | 10
22 | 12309 | 12310 | 0x3015 | 1 | 5
23 | 12310 | 12311 | 0x3016 | 1 | 6 | 11
24 | 12311 | 12312 | 0x3017 | 1 | 7
25 | 12312 | 12313 | 0x3018 | 1 | 8 | 12
26 | 12313 | 12314 | 0x3019 | 1 | 9
27 | 12314 | 12315 | 0x301A | 1 | 10 | 13
28 | 12315 | 12316 | 0x301B | 1 | 11
29 | 12316 | 12317 | 0x301C | 1 | 12 | 14
30 | 12317 | 12318 | 0x301D | 1 | 13
31 | 12318 | 12319 | 0x301E | 1 | 14 | 15
32 | 12319 | 12320 | 0x301F | 1 | 15
33 | 12320 | 12321 | 0x3020 | 2 | 0 | 16
34 | 12321 | 12322 | 0x3021 | 2 | 1
35 | 12322 | 12323 | 0x3022 | 2 | 2 | 17
36 | 12323 | 12324 | 0x3023 | 2 | 3
37 | 12324 | 12325 | 0x3024 | 2 | 4 | 18
38 | 12325 | 12326 | 0x3025 | 2 | 5
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
1781 | 14068 | 14069 | 0x36F4 | 111 | 4 | 890
1782 | 14069 | 14070 | 0x36F5 | 111 | 5 | -9999999148
1783 | 14070 | 14071 | 0x36F6 | 111 | 6 | 891
1784 | 14071 | 14072 | 0x36F7 | 111 | 7 | -9999999147
1785 | 14072 | 14073 | 0x36F8 | 111 | 8 | 892
1786 | 14073 | 14074 | 0x36F9 | 111 | 9 | -9999999146
1787 | 14074 | 14075 | 0x36FA | 111 | 10 | 893
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
