Ovikian/TMEIC-DI-Water-Cooling-Skid-Repo/Testing Documentation/first_order_lp_flow_conductivity.docx

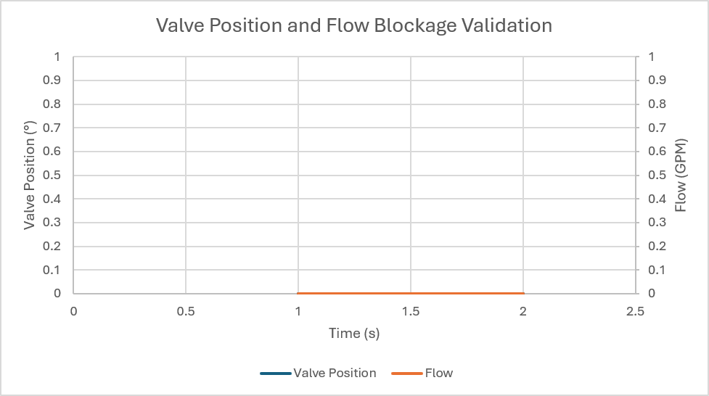
[picture p76: figure]
