Ovikian/TMEIC-DI-Water-Cooling-Skid-Repo/(list of files, cad)

Other CAD files:
Documentation/AUTOCADTEMPLATEARCHD.dwg
HMI/MINI COOLING SKID P&ID Rev 2 - Copy.dwg
