Ovikian/TMEIC-DI-Water-Cooling-Skid-Repo/Testing Documentation/3-Way Valve Open Loop Actuation Test.docx

Figure 1: Open Loop 3-Way Valve Actuation Test. Primary Axis is valve position in degrees. Secondary Axis is setpoint error in degrees.

Figure 1 illustrates the open loop actuation. The maximum position is 90 degrees and the minimum is 0 degrees. The setpoint-feedback error to generally remain below 0.5, illustrating high accuracy within the actuation. Although the lack of precision shown through the feedback is fairly negligible especially when compared to the entire range of motion, a PID controller may be able to further improve operation. Additionally, the PID controller will serve for redundancy, as accuracy and precision of the open loop system will likely erode throughout the lifetime of the valve usage. The actuation of the valve appears fairly linear, with a rate of change averaging at around 4 degrees per second, (see Figure 2 With an entire range of 90 degrees, the calculated time of full actuation is approximately 24 seconds, which is slightly longer than what the manual specifies. ), However the values within figure 2, have a with a variance of 0.2, and a standard deviation of 0.4, indicating varying rates of change. It is possible that greater power is attributed to greater differences as indicated with the quickest rate of change occurring from open to close. Regardless of small inaccuracies, this experiment illustrates the following:

- Communication between the PLC, and 3-Way-Valve for actuation, and feedback
- Ability to Control Actuation Magnitude and Direction of the 3-way valve Through the PLC.
- Illustrates valve actuation characteristics (contradicting expected exponential curve)
- Verifies Valve Specification.
- Open Loop Tracking Error With the 3-way-valve

The next step would be to working on the PID Control for the 3-way valve. We’ll likely try to use a simple PI law, with proportional gain of 1, and a integ
