Ovikian/TMEIC-DI-Water-Cooling-Skid-Repo/Testing Documentation/Validation Plan.xlsx

Test Name | Test Description | Test Procedure | Outcomes | Notes | Status
Measurement Accuracy | Test shall ensure that measurements taken from instruments are accurate and precise within a reasonable range | 1. Compare measurements of RTDs, Flow Meter, Conductivity Sensor, & Valve Position with calibrated instruments and ensure accuracy 2. Measurements of RTDs, Flow Meters, Conductivity Sensor, and Valve Positions shall be precise, such that trends are consistent and non-noisy | 1. Validates Calibration of Instruments for Final Use by Operator 2. Provides Creedance to additional Testing to Validate Process Control Accuracy 3. Permits for readable and accessible data for operator usage | • RTD, Analog Conductivity, Flow Completed for Accuracy • Will Implement1st LP Filters for Precision • Finalize proof | In Progress
System Startup & Shutdown | Tests shall ensure that operators can successfully startup system in both from off, standby, and fault states | 1. Ensure system is deenergized 2. From a deenergized state, bring the system to running state 3. From a standby state, bring the system to a running state 4. From a fault state, bring the system to a running state. 5. Digitally shutdown system during all states of operation. 6. Ensure physical shutdown switch works | 1. Validates Internal Memory Storage of PLC 2. Validates Software Sequence Operation & Safety Interlock for Faults 3. Validates Adequate Power Distribution & Protection to PLC and instrumentation | • Effectively completed by usage of operation • Run test on complete skid, and finalize proof | In Progress
Sensor Failure | During operation, the operator will remove data lines and/or deenergize various instruments and observe the resulting behavior of the PLC | 1. Disconnect the following sensors one at a time and observe alarms: RTD 1, RTD2, RTD3, Valve Feedback, Conductivity Analog, Flow Sensor, Voltage Sensor, and current sensor 2. Disconnect 2 RTDs and observe results 3. Disconnected the Water Low Low Line and observe Results 4. Disconnect Digital Conductivity Sensors and Raise Conductivity to alarm and faults points 5. Deenergize 3-Way Valve During Operation - observe results. 6. Deenergize conductivity PLC and observe results | 1. Validates instrumentation connection to PLC. 2. Validates adequate power distribution, and adaptability to changing loads. 3. Validates software fault and alarm interlocks, and detectability of bad signals | • Not to be started until final completion of skid | Not Started
Temperature Regulation | During operation, the operator will change the setpoint of the temperature. The result of these changes shall be observed both in the physical instruments and PLC | 1. Increase the setpoint by 1°C, 3°C, and 6°C and observe system response 2. Decrease the setpoint by 1°C, 3°C, and 6°C and observe system response 3. Attempt to overflow and underflow setpoints. Observe system response and results 4. Attempt to change setpoint while system is in diagnostic and initialization phase 5. Change setpoint below process variable, manually control valve to cool below setpoint, the disable manual control. Observe results 6. Create setpoint change and then restrict flow to force a system fault 7. Change setpoint by -3°C, and whilst system adjusts change setpoint again by +1°C 8. Change setpoint and then immediately switch pumps manually 9. Change setpoint to lowest possible value from highest possible value. Observe results 10. Run temperature regulation with 0 fans, 1 fan, and 2 fans engaged | 1. Validates Regulation Ability of Temperature Controller in Software 2. Validates Error Prevention of Software system 3. Validates Interlocking behavior of software system 3. Validates accuracy, precision and observability of RTDs 4. Validates accuracy, precision observability and controllability of 3-way-valve instrument 5. Validates steady state distribution of power to PLC and instruments 6. Validates robustness of power system from constant and variable consumption of a servo motor 7. Validates PLC-HMI User Interface | • Not to be started until final completion of skid | Not started
Pump Turnover Testing | During operation, the system will attempt to automatically conduct switches to pumps, for cycling, and for hydraulic failures. Additionally, the operator may also wish to switch pumps. Conditions which allow and prevent switches and potential faults shall be considered here | 1. Enable pump cycling and ensure that pumps cycle at "hour" limits. 2. Engage pump cycling, then engage simplex mode. Ensure pump cycling is automatically disabled. With simplex mode still engaged, attempt to reengage pump cycling. 3. Manually switch from primary to secondary and back to primary. 4. Attempt to switch pumps while system is in diagnostic and initialization phase. 5. Enable simplex mode and attempt to manually switch pumps. 6. While simplex mode is disengaged, disconnect a pump from power - observe results. 7. Reconnect now de-active pump and disconnect now active pump - observe results. 8. DO NOT reconnect de-active pump and disconnect active pump. Observe results. 9. Manually switch a pump. While initializing, create fault condition with level sensors. Observe results. 10. Shutdown system during pump switching. 11. Engage pump cycling, allow pump to almost reach limit, then rebalance pumps | 1. Validates software interlock, logic, and execution for pump switching. 2. Validates automatic and manual control over pumps. 3. Validates accuracy, precision, and observability of voltage, current, flow, and pressure instrumentation 4. Validates power distribution and protection across static and changing loads with DC motors. 5. Validates PLC-HMI Interface | • Logic and interlocks mostly tested and successful • Hypothetical tests indicate proper system response • Final test on completed skid to validate power • Finalize proof | In Progress
Fault Conditions | The system shall encounter various fault conditions during operation of the skid. This test will attempt to explore all of these, and subsequent corrections, observing results | A. For all faults: after engaging a fault, attempt to restart the system without overriding, then attempt it with override (but don't fix the fault), and then finally fix the fault, and attempt a restart with an override. B. Engage the following faults, and then correct: 1. Engage both water low and water low low 2. Engage only water lo wlow 3. Cause conductivity to become high, and then excessive 4.Lower conductivity threshold in plc program to create anomalous condition 5. Disconnect pump voltage sensor 6. Engage simplex mode and disconnect pump power. Do this for primary and secondary pumps 7. Force valve into manual mode, and allow temperature to exceed 8. Destabilize P controller for valve and/or PI controller for temperature 9. Manually lower flow rate until fault. 10. Force a short circuit with pump wiring. 11. Press random buttons 12. Engage simplex mode and then drain system of all water. Observe results 13. Attempt to start machine with only secondary pump connected. 14. Attempt to start system with no pumps connected | 1. Validates instrumentation accuracy, precision, and observation 2. Validates software logic, and execution for faults, and fault overrides 3. Validates power distribution and protection of a constantly restarting system 4. Validates power protection against short circuits 5. Validates PLC-HMI Interface | • Fault conditions to be final tests - allowing for unobstructed continued testing and operation of skid during construction | Not Started
Manual Control | The operator may be allowed to control the valve and fans manually - this test ensures that such a feature is always available | 1. Toggle manual fan control and force fan operation during standby, diagnostics, initialization, running, and fault phases. 2. Play with valve position manually during all system states and phases. | 1. Validates control and communication with fan and valve 2. Validates power distribution and load for changing DC motor loads, and variable servo motor, in various states 3. Validates operator controllability of fans and valve 4. Validates PLC-HMI Interface | • Effectively complete, but will need to run final test on built skid • Finalize proof | In Progress
Data Collection | The operator may desire to collect data. This test ensures that this is possible, and that SD card operations does not interfere with operations | 1. Collect data of all instruments during operation and store on SD card. 2. Create condition for unreadable SD card, and ensure system operation | 1. Validates communication, observation, accuracy and precision of all instruments. 2. Validates software interaction with all instruments, and ability to record data 3. Validates power distribution on fully active system. | • Data collection possible and bit-wise proof • Test on full skid and unreadable SD for full run. • Finalize proof | In Progress
