Ovikian/TMEIC-DI-Water-Cooling-Skid-Repo/Testing Documentation/PercDiffSimCalc.xlsx

Measurements | Simulation Value | Calculated Value | % Difference
Total Loop Flow (GPM) | 5.9129 | 5.9 | 0.2184053027
DI Loop Flow (GPM) | 0.9061 | 0.9 | 0.6754886219
Main Loop Flow (GPM) | 5.0069 | 5 | 0.1379048457
SS Temp @ 100% Throughput (°C) | 25.3948 | 26.87 | 5.64509957
Pump Outlet Pressure (Gauge PSI) | 8.3829 | 8.23 | 1.840738222
Pump Inlet Pressure (Gauge PSI) | 0.2245 | 0.21 | 6.904761905
