Ovikian/TMEIC-DI-Water-Cooling-Skid-Repo/Testing Documentation/17092026-transmitter-testing.xlsx

Load current (A) | Output current (mA) | Input Voltage (V) | Output Current (mA)
0 | 3.98 | 0 | 3.99
0.5 | 4.37 | 5 | 5.56
1 | 4.77 | 10 | 7.22
1.5 | 5.18 | 15 | 8.78
2 | 5.57 | 20 | 10.47
2.5 | 5.97 | 21 | 10.77
3 | 6.36 | 22 | 11.03
3.5 | 6.77 | 23 | 11.35
4 | 7.15 | 24 | 11.69
4.5 | 7.56 | 25 | 12.02
 |  | 26 | 12.35
 |  | 27 | 12.71
