Ovikian/TMEIC-DI-Water-Cooling-Skid-Repo/Testing Documentation/IntergralWTransRegulator.pdf

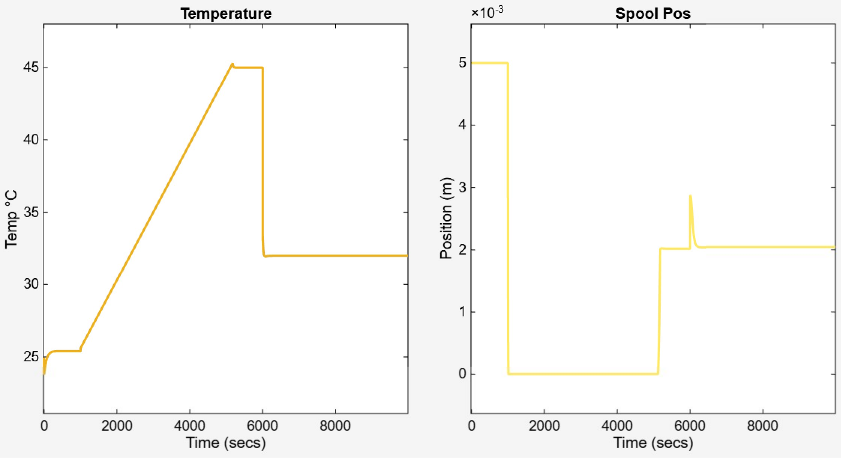
[picture p77: figure]
