Ovikian/TMEIC-DI-Water-Cooling-Skid-Repo/Testing Documentation/temprisetime.pdf

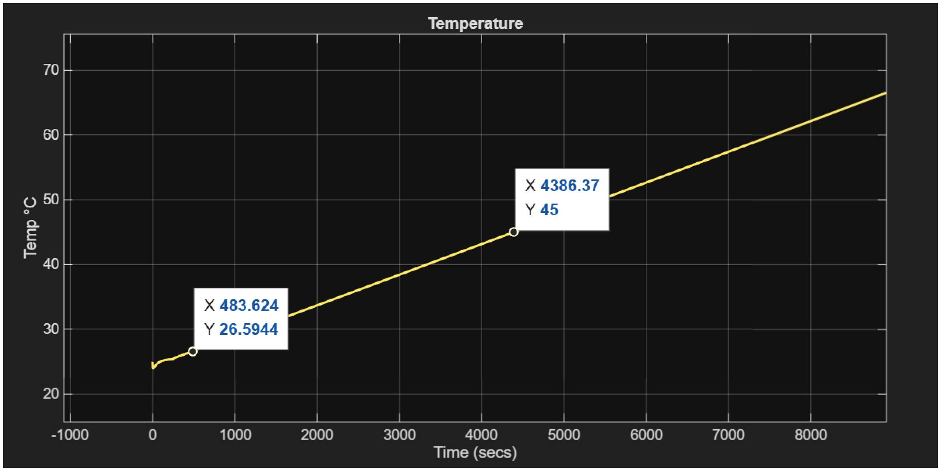
[picture p78: figure]
