Ovikian/TMEIC-DI-Water-Cooling-Skid-Repo/Testing Documentation/IntergralOverCorrect.pdf

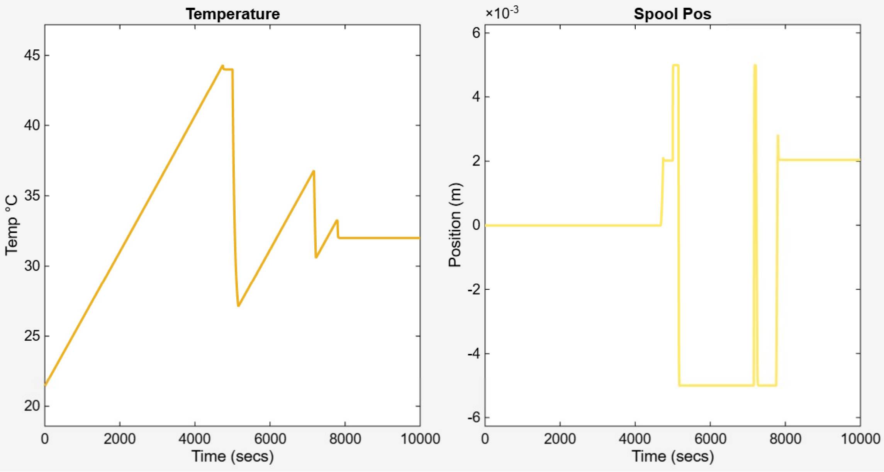
[picture p79: figure]
