Ovikian/TMEIC-DI-Water-Cooling-Skid-Repo/Testing Documentation/3wayvalveresponse1.pdf

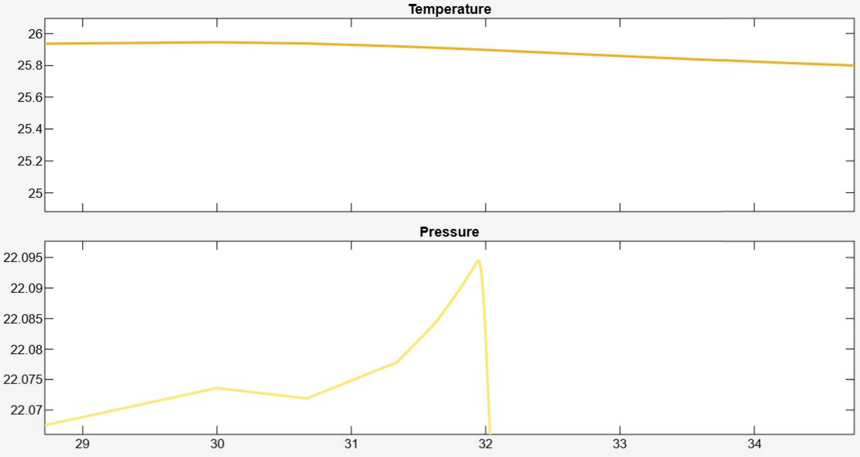
[picture p80: figure]
