Ovikian/TMEIC-DI-Water-Cooling-Skid-Repo/Testing Documentation/3wayvalveresponse2.pdf

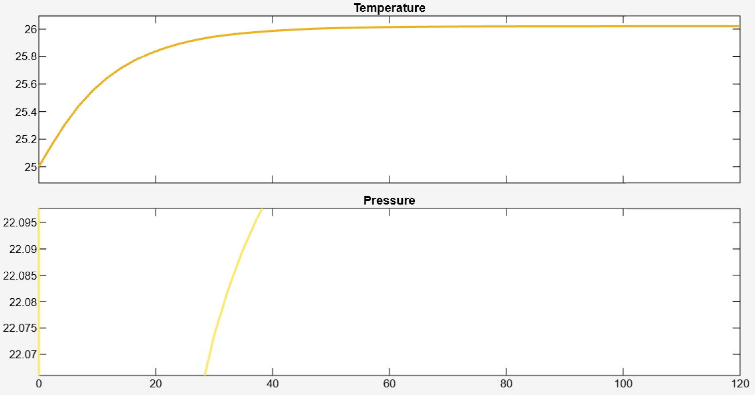
[picture p81: figure]
