Ovikian/TMEIC-DI-Water-Cooling-Skid-Repo/Testing Documentation/3wayvalveresponse3stable.pdf

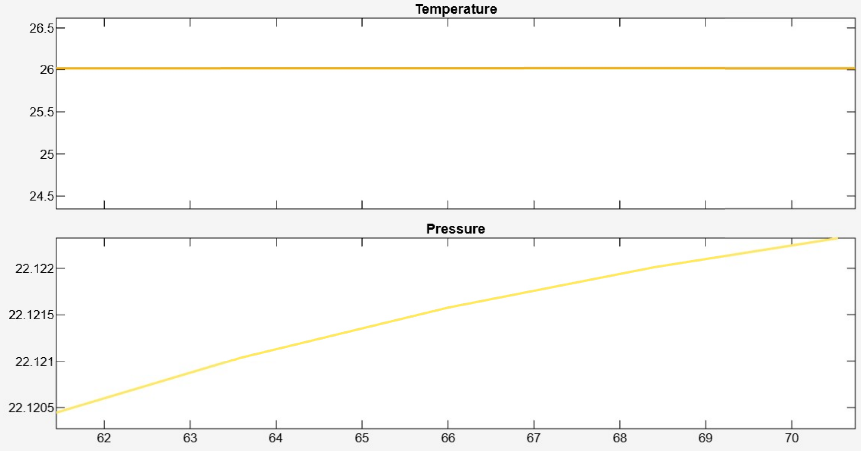
[picture p82: figure]
