Ovikian/TMEIC-DI-Water-Cooling-Skid-Repo/Testing Documentation/3WVDynamicTESTA.pdf

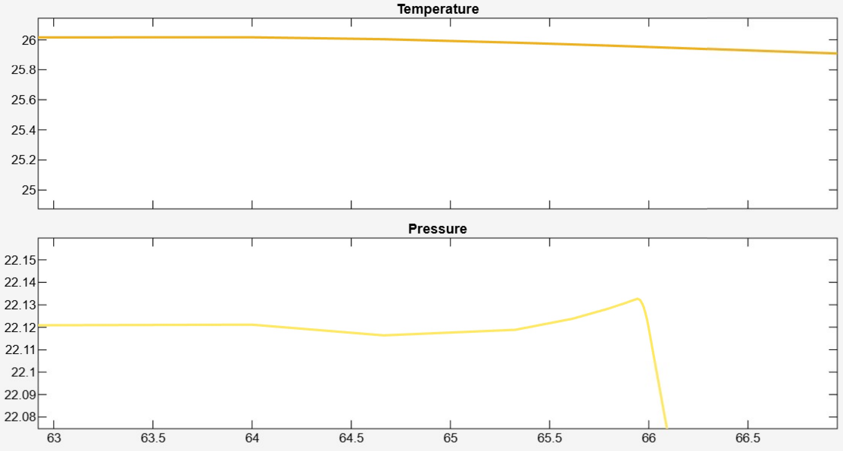
[picture p83: figure]
