Ovikian/TMEIC-DI-Water-Cooling-Skid-Repo/Testing Documentation/3WVDynamicTESTB.pdf

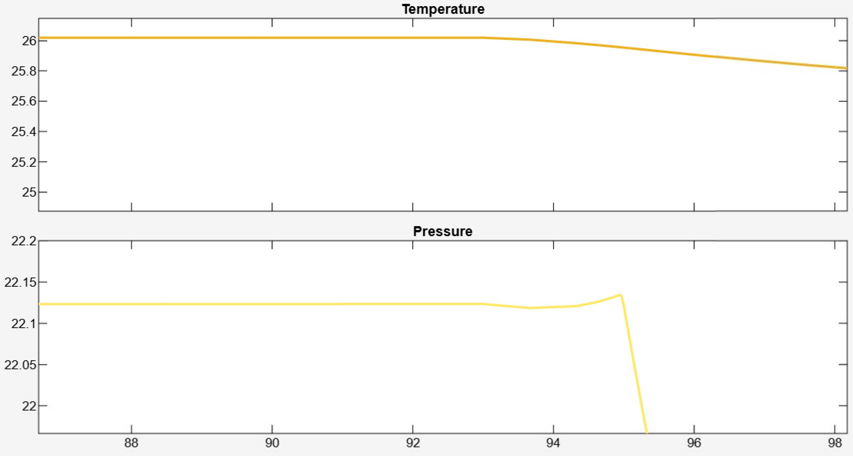
[picture p84: figure]
