Ovikian/TMEIC-DI-Water-Cooling-Skid-Repo/Testing Documentation/3WVStaticTESTA.pdf

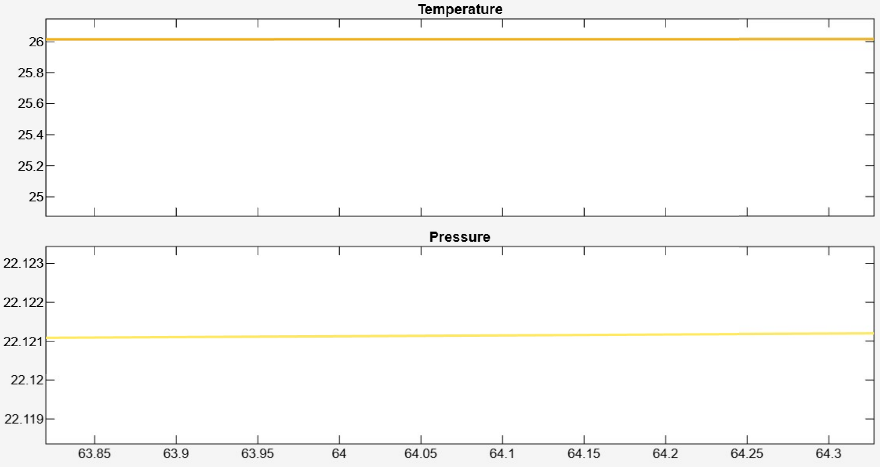
[picture p85: figure]
