Ovikian/TMEIC-DI-Water-Cooling-Skid-Repo/Testing Documentation/3WVStaticTESTB.pdf

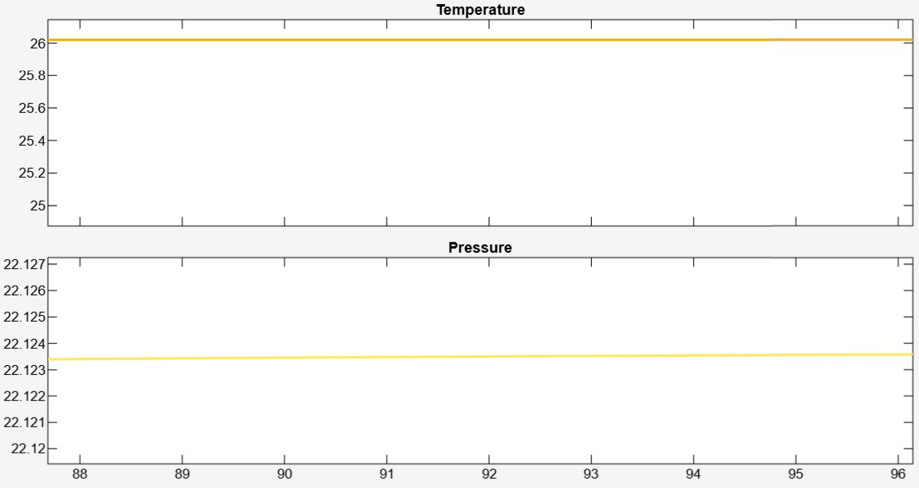
[picture p86: figure]
