Ovikian/TMEIC-DI-Water-Cooling-Skid-Repo/Testing Documentation/radspersomething.pdf

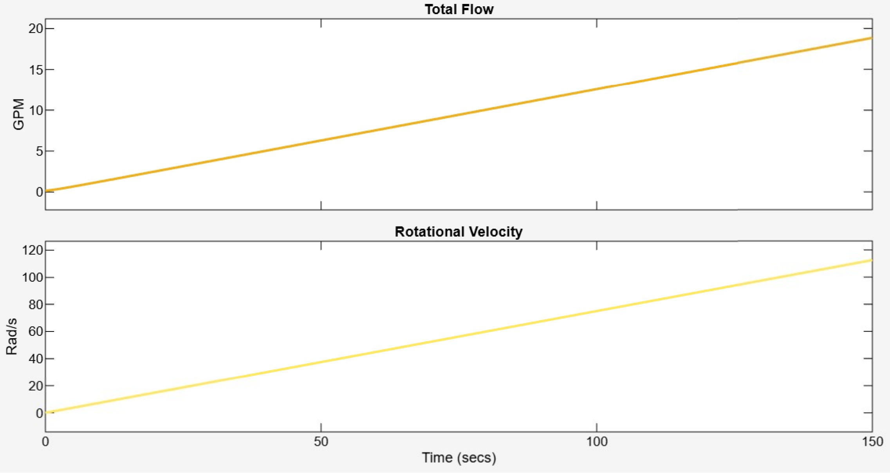
[picture p87: figure]
