Ovikian/TMEIC-DI-Water-Cooling-Skid-Repo/Testing Documentation/conductivity_test.xlsx

0 | 0.399209 |  |  | TIME | CONDUCT | 0.0061877395 | 0.000399209 | 0.001996045
0.012 | 0.355951 |  |  | 0 | 0.4 | 0.01770089958 | 0.000754760791 | 0.003765819775
0.022 | 0.370782 |  |  | 0.02 | 0.4 | 0.02841653319 | 0.00112478803 | 0.005600900676
0.033 | 0.402917 |  |  | 0.032 | 0.4 | 0.03952795516 | 0.001526580242 | 0.007587481173
0.043 | 0.333704 |  |  | 0.05 | 0.4 | 0.04972021405 | 0.001858757662 | 0.009218063767
0.053 | 0.339884 |  |  | 0.061 | 0.4 | 0.05861950141 | 0.002196782904 | 0.01087139345
0.072 | 0.342356 |  |  | 0.071 | 0.4 | 0.06737701687 | 0.002536942121 | 0.01252881648
0.082 | 0.354715 |  |  | 0.09 | 0.4 | 0.07609292985 | 0.002889120179 | 0.0142397474
0.092 | 0.347299 |  |  | 0.11 | 0.4 | 0.08461526602 | 0.003233530059 | 0.01590504366
0.102 | 0.359659 |  |  | 0.122 | 0.4 | 0.09295004178 | 0.003589955529 | 0.01762381344
0.113 | 0.353479 |  |  | 0.14 | 0.4 | 0.1011222295 | 0.003939844573 | 0.01930308938
0.122 | 0.351007 |  |  | 0.151 | 0.4 | 0.1089069734 | 0.004286911729 | 0.02096160893
0.132 | 0.401681 |  |  | 0.17 | 0.4 | 0.1171975212 | 0.004684305817 | 0.02286520588
0.142 | 0.332468 |  |  | 0.19 | 0.4 | 0.1249437075 | 0.005012089511 | 0.02441321985
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
