Ovikian/TMEIC-DI-Water-Cooling-Skid-Repo/Testing Documentation/Timer Converter.xlsm

T#0ms | 0ms | 0 | 0 | 0 | 0 | 0 | 0
T#12ms | 12ms | 12 | 12 | 12 | 12 | 12 | 0.012
T#22ms | 22ms | 22 | 22 | 22 | 22 | 22 | 0.022
T#33ms | 33ms | 33 | 33 | 33 | 33 | 33 | 0.033
T#43ms | 43ms | 43 | 43 | 43 | 43 | 43 | 0.043
T#53ms | 53ms | 53 | 53 | 53 | 53 | 53 | 0.053
T#72ms | 72ms | 72 | 72 | 72 | 72 | 72 | 0.072
T#82ms | 82ms | 82 | 82 | 82 | 82 | 82 | 0.082
T#92ms | 92ms | 92 | 92 | 92 | 92 | 92 | 0.092
T#102ms | 102ms | 102 | 102 | 102 | 102 | 102 | 0.102
T#113ms | 113ms | 113 | 113 | 113 | 113 | 113 | 0.113
T#122ms | 122ms | 122 | 122 | 122 | 122 | 122 | 0.122
T#132ms | 132ms | 132 | 132 | 132 | 132 | 132 | 0.132
T#142ms | 142ms | 142 | 142 | 142 | 142 | 142 | 0.142
T#152ms | 152ms | 152 | 152 | 152 | 152 | 152 | 0.152
T#163ms | 163ms | 163 | 163 | 163 | 163 | 163 | 0.163
T#182ms | 182ms | 182 | 182 | 182 | 182 | 182 | 0.182
T#193ms | 193ms | 193 | 193 | 193 | 193 | 193 | 0.193
T#203ms | 203ms | 203 | 203 | 203 | 203 | 203 | 0.203
T#212ms | 212ms | 212 | 212 | 212 | 212 | 212 | 0.212
T#223ms | 223ms | 223 | 223 | 223 | 223 | 223 | 0.223
T#233ms | 233ms | 233 | 233 | 233 | 233 | 233 | 0.233
T#248ms | 248ms | 248 | 248 | 248 | 248 | 248 | 0.248
T#262ms | 262ms | 262 | 262 | 262 | 262 | 262 | 0.262
T#272ms | 272ms | 272 | 272 | 272 | 272 | 272 | 0.272
T#282ms | 282ms | 282 | 282 | 282 | 282 | 282 | 0.282
T#292ms | 292ms | 292 | 292 | 292 | 292 | 292 | 0.292
T#302ms | 302ms | 302 | 302 | 302 | 302 | 302 | 0.302
T#312ms | 312ms | 312 | 312 | 312 | 312 | 312 | 0.312
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
T#18s633ms | 18s633ms | 18s633 | 18*1000+633 | 18*1000+633 | 18*1000+633 | 18633 | 18.633
T#18s643ms | 18s643ms | 18s643 | 18*1000+643 | 18*1000+643 | 18*1000+643 | 18643 | 18.643
T#18s662ms | 18s662ms | 18s662 | 18*1000+662 | 18*1000+662 | 18*1000+662 | 18662 | 18.662
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
