Ovikian/TMEIC-DI-Water-Cooling-Skid-Repo/Testing Documentation/3wayvalvevregtesting.xlsx

Test Num | Kp Val
1 | 1 | FAIL
2 | 1 | DONE | UP
3 | 1 | DONE | DOWN
4 | 5 | DONE | UP
5 | 5 | DONE | DOWN
6 | 0.5 | DONE | UP
7 | 0.5 | DONE | DOWN
8 | 0.7 | DONE | UP
9 | 0.7 | DONE | DOWN
10 | 0.25 | DONE | UP
11 | 0.25 | DONE | DOWN
