Ovikian/TMEIC-DI-Water-Cooling-Skid-Repo/Testing Documentation/10-6-ValveTestRateOfChangeActuation.xlsx

Δt | x2 | x1 | Δx | ≈ dx/dt |  | Average dx/dt
3.851 | 13.31868 | 0.505495 | 12.813185 | 3.327235783 | 1 | 3.83754069
3.63 | 41.05495 | 27.64835 | 13.4066 | 3.693278237 | 2 | 3.83754069
3.98 | 55.1978 | 41.05495 | 14.14285 | 3.553479899 | 3 | 3.83754069
3.591 | 68.60439 | 55.24176 | 13.36263 | 3.721144528 | 4 | 3.83754069
3.713 | 82.20879 | 68.69231 | 13.51648 | 3.640312416 | 5 | 3.83754069
2.479 | 89.94505 | 82.25275 | 7.6923 | 3.102985075 | 6 | 3.83754069
18.798 | 89.94505 | 0.0659341 | 89.8791159 | 4.781312688 | 7 | 3.83754069
5.761 | 22.48352 | 0.021978 | 22.461542 | 3.898896372 | 8 | 3.83754069
5.37 | 45.04396 | 22.52747 | 22.51649 | 4.193014898 | 9 | 3.83754069
5.311 | 67.3956 | 45.08791 | 22.30769 | 4.20028055 | 10 | 3.83754069
5.461 | 89.83516 | 67.43956 | 22.3956 | 4.101007142 | 11 | 3.83754069
 |  |  |  | 0.1977962808
 |  |  |  | 0.4447429379
