Ovikian/TMEIC-DI-Water-Cooling-Skid-Repo/Testing Documentation/10-6-26-3-WAY-VALVE-TEST.xlsx

Raw I | Raw FB | C Input | C FB | Power | Time | T# Removed |  | ms Removed |  |  |  |  |  |  | s
0 | 3 | 0 | 8.24176e-3 | 0 | T#0ms |  | 0ms | 0 |  |  |  |  | 0 | ms | 0 | 0.008241255113
0 | 3 | 0 | 8.24176e-3 | 0 | T#19ms |  | 19ms | 19 |  |  |  |  | 19 | ms | 0.019 | 0.008241255113
0 | 3 | 0 | 8.24176e-3 | 0 | T#39ms |  | 39ms | 39 |  |  |  |  | 39 | ms | 0.039 | 0.008241255113
0 | 3 | 0 | 8.24176e-3 | 0 | T#59ms |  | 59ms | 59 |  |  |  |  | 59 | ms | 0.059 | 0.008241255113
0 | 3 | 0 | 8.24176e-3 | 0 | T#79ms |  | 79ms | 79 |  |  |  |  | 79 | ms | 0.079 | 0.008241255113
0 | 3 | 0 | 8.24176e-3 | 0 | T#101ms |  | 101ms | 101 |  |  |  |  | 101 | ms | 0.101 | 0.008241255113
0 | 3 | 0 | 8.24176e-3 | 0 | T#119ms |  | 119ms | 119 |  |  |  |  | 119 | ms | 0.119 | 0.008241255113
0 | 3 | 0 | 8.24176e-3 | 0 | T#132ms |  | 132ms | 132 |  |  |  |  | 132 | ms | 0.132 | 0.008241255113
0 | 3 | 0 | 8.24176e-3 | 0 | T#149ms |  | 149ms | 149 |  |  |  |  | 149 | ms | 0.149 | 0.008241255113
0 | 3 | 0 | 8.24176e-3 | 0 | T#169ms |  | 169ms | 169 |  |  |  |  | 169 | ms | 0.169 | 0.008241255113
0 | 3 | 0 | 8.24176e-3 | 0 | T#179ms |  | 179ms | 179 |  |  |  |  | 179 | ms | 0.179 | 0.008241255113
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
