Ovikian/TMEIC-DI-Water-Cooling-Skid-Repo/Testing Documentation/3WayValveAnalysis.xlsx

Time (s) | Command Signal (°) | Feedback Signal (°) | Error (Δ°) |  | % SS Error | SS Error(Δ°) | SS Error(Δ°) Average Filter (1st Order) | SS Error(Δ°) Average Filter (2nd Order) | SS Error(Δ°) Average Filter (3rd Order)
0 | 0 | 0.00824176 | 0.00824176 | 0.824176 | 0 | 0
0.019 | 0 | 0.00824176 | 0.00824176 | 0.824176 | 0 | 0 | 0
0.039 | 0 | 0.00824176 | 0.00824176 | 0.824176 | 0 | 0 | 0 | 0
0.059 | 0 | 0.00824176 | 0.00824176 | 0.824176 | 0 | 0 | 0 | 0 | 0
0.079 | 0 | 0.00824176 | 0.00824176 | 0.824176 | 0 | 0 | 0 | 0 | 0
0.101 | 0 | 0.00824176 | 0.00824176 | 0.824176 | 0 | 0 | 0 | 0 | 0
0.119 | 0 | 0.00824176 | 0.00824176 | 0.824176 | 0 | 0 | 0 | 0 | 0
0.132 | 0 | 0.00824176 | 0.00824176 | 0.824176 | 0 | 0 | 0 | 0 | 0
0.149 | 0 | 0.00824176 | 0.00824176 | 0.824176 | 0 | 0 | 0 | 0 | 0
0.169 | 0 | 0.00824176 | 0.00824176 | 0.824176 | 0 | 0 | 0 | 0 | 0
0.179 | 0 | 0.00824176 | 0.00824176 | 0.824176 | 0 | 0 | 0 | 0 | 0
0.192 | 0 | 0.00824176 | 0.00824176 | 0.824176 | 0 | 0 | 0 | 0 | 0
0.209 | 0 | 0.00824176 | 0.00824176 | 0.824176 | 0 | 0 | 0 | 0 | 0
0.222 | 0 | 0.00824176 | 0.00824176 | 0.824176 | 0 | 0 | 0 | 0 | 0
0.239 | 0 | 0.00824176 | 0.00824176 | 0.824176 | 0 | 0 | 0 | 0 | 0
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
