Ovikian/TMEIC-DI-Water-Cooling-Skid-Repo/Testing Documentation/100726TESTSRAWDATA/100726FANINPUTTEST1R0.csv

Time(s) | Enable Manual Fan Control | Force Fan 1 On Press | Force Fan 2 On Press | Fan 1 Active | Fan 2 Active
T#0ms | FALSE | FALSE | FALSE | FALSE | FALSE
T#0ms | FALSE | FALSE | FALSE | FALSE | FALSE | FALSE | FALSE
T#23ms | FALSE | FALSE | FALSE | FALSE | FALSE
T#23ms | FALSE | FALSE | FALSE | FALSE | FALSE | FALSE | FALSE
T#43ms | FALSE | FALSE | FALSE | FALSE | FALSE
T#43ms | FALSE | FALSE | FALSE | FALSE | FALSE | FALSE | FALSE
T#63ms | FALSE | FALSE | FALSE | FALSE | FALSE
T#63ms | FALSE | FALSE | FALSE | FALSE | FALSE | FALSE | FALSE
T#83ms | FALSE | FALSE | FALSE | FALSE | FALSE
T#83ms | FALSE | FALSE | FALSE | FALSE | FALSE | FALSE | FALSE
T#113ms | FALSE | FALSE | FALSE | FALSE | FALSE
T#113ms | FALSE | FALSE | FALSE | FALSE | FALSE | FALSE | FALSE
T#134ms | FALSE | FALSE | FALSE | FALSE | FALSE
T#134ms | FALSE | FALSE | FALSE | FALSE | FALSE | FALSE | FALSE
T#163ms | FALSE | FALSE | FALSE | FALSE | FALSE
T#163ms | FALSE | FALSE | FALSE | FALSE | FALSE | FALSE | FALSE
T#184ms | FALSE | FALSE | FALSE | FALSE | FALSE
T#184ms | FALSE | FALSE | FALSE | FALSE | FALSE | FALSE | FALSE
T#203ms | FALSE | FALSE | FALSE | FALSE | FALSE
T#203ms | FALSE | FALSE | FALSE | FALSE | FALSE | FALSE | FALSE
T#223ms | FALSE | FALSE | FALSE | FALSE | FALSE
T#223ms | FALSE | FALSE | FALSE | FALSE | FALSE | FALSE | FALSE
T#243ms | FALSE | FALSE | FALSE | FALSE | FALSE
T#243ms | FALSE | FALSE | FALSE | FALSE | FALSE | FALSE | FALSE
T#263ms | FALSE | FALSE | FALSE | FALSE | FALSE
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
T#1m27s956ms | FALSE | FALSE | FALSE | FALSE | FALSE | TRUE | FALSE
T#1m27s986ms | FALSE | FALSE | FALSE | FALSE | FALSE | TRUE | FALSE
T#1m28s16ms | FALSE | FALSE | FALSE | FALSE | FALSE | TRUE | FALSE
T#1m28s46ms | FALSE | FALSE | FALSE | FALSE | FALSE | TRUE | FALSE
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
