Ovikian/TMEIC-DI-Water-Cooling-Skid-Repo/Testing Documentation/100726TESTSRAWDATA/100726FANINPUTTEST1R1.csv

Time(s) | Enable Manual Fan Control | Force Fan 1 On Press | Force Fan 2 On Press | Fan 1 Active | Fan 2 Active
T#0ms | FALSE | FALSE | FALSE | FALSE | FALSE | FALSE | FALSE
T#26ms | FALSE | FALSE | FALSE | FALSE | FALSE | FALSE | FALSE
T#51ms | FALSE | FALSE | FALSE | FALSE | FALSE | FALSE | FALSE
T#81ms | FALSE | FALSE | FALSE | FALSE | FALSE | FALSE | FALSE
T#112ms | FALSE | FALSE | FALSE | FALSE | FALSE | FALSE | FALSE
T#141ms | FALSE | FALSE | FALSE | FALSE | FALSE | FALSE | FALSE
T#171ms | FALSE | FALSE | FALSE | FALSE | FALSE | FALSE | FALSE
T#202ms | FALSE | FALSE | FALSE | FALSE | FALSE | FALSE | FALSE
T#233ms | FALSE | FALSE | FALSE | FALSE | FALSE | FALSE | FALSE
T#261ms | FALSE | FALSE | FALSE | FALSE | FALSE | FALSE | FALSE
T#291ms | FALSE | FALSE | FALSE | FALSE | FALSE | FALSE | FALSE
T#322ms | FALSE | FALSE | FALSE | FALSE | FALSE | FALSE | FALSE
T#352ms | FALSE | FALSE | FALSE | FALSE | FALSE | FALSE | FALSE
T#382ms | FALSE | FALSE | FALSE | FALSE | FALSE | FALSE | FALSE
T#412ms | FALSE | FALSE | FALSE | FALSE | FALSE | FALSE | FALSE
T#442ms | FALSE | FALSE | FALSE | FALSE | FALSE | FALSE | FALSE
T#472ms | FALSE | FALSE | FALSE | FALSE | FALSE | FALSE | FALSE
T#502ms | FALSE | FALSE | FALSE | FALSE | FALSE | FALSE | FALSE
T#531ms | FALSE | FALSE | FALSE | FALSE | FALSE | FALSE | FALSE
T#562ms | FALSE | FALSE | FALSE | FALSE | FALSE | FALSE | FALSE
T#592ms | FALSE | FALSE | FALSE | FALSE | FALSE | FALSE | FALSE
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
T#20s502ms | FALSE | FALSE | FALSE | FALSE | FALSE | TRUE | FALSE
T#20s532ms | FALSE | FALSE | FALSE | FALSE | FALSE | TRUE | FALSE
T#20s562ms | FALSE | FALSE | FALSE | FALSE | FALSE | TRUE | FALSE
T#20s592ms | FALSE | FALSE | FALSE | FALSE | FALSE | TRUE | FALSE
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
