Ovikian/TMEIC-DI-Water-Cooling-Skid-Repo/Documentation/SysSeq.pdf

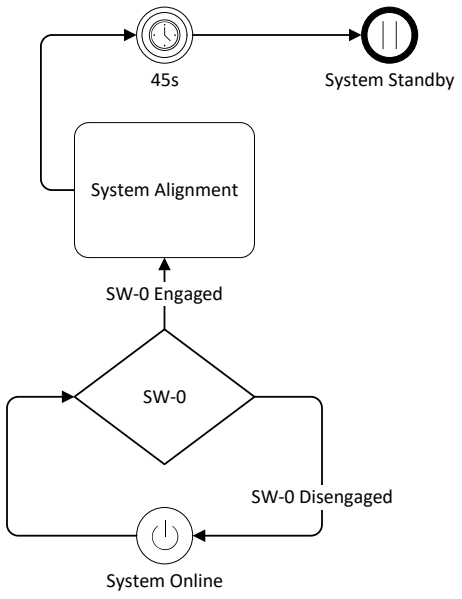
[picture p88: figure]
System Online; System Alignment; System Standby; SW-0 Engaged; SW-0 Disengaged

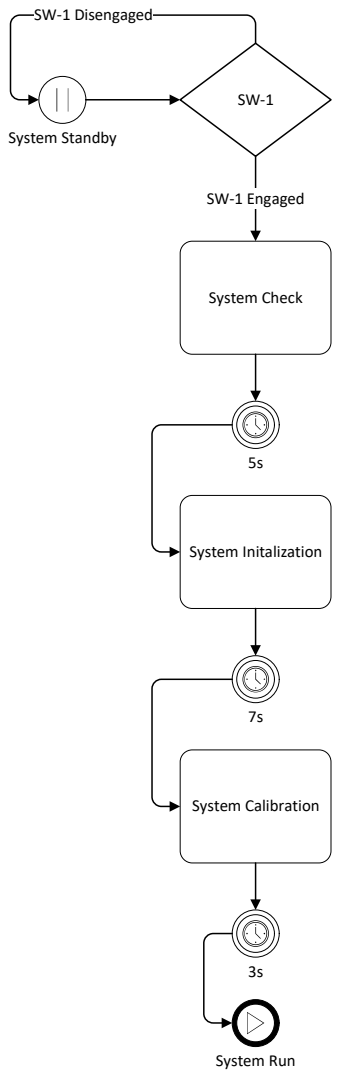
[picture p89: page 4]
SW-1 Disengaged; System Check; SW-1 Engaged; System Initalization; System Standby; System Calibration; System Run

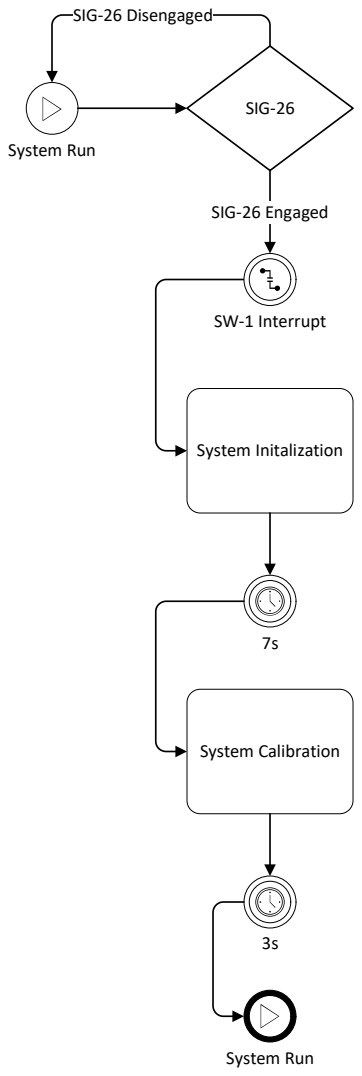
[picture p90: page 5]
SIG-26 Engaged; System Initalization; System Calibration; System Run; SIG-26; SIG-26 Disengaged; SW-1 Interrupt

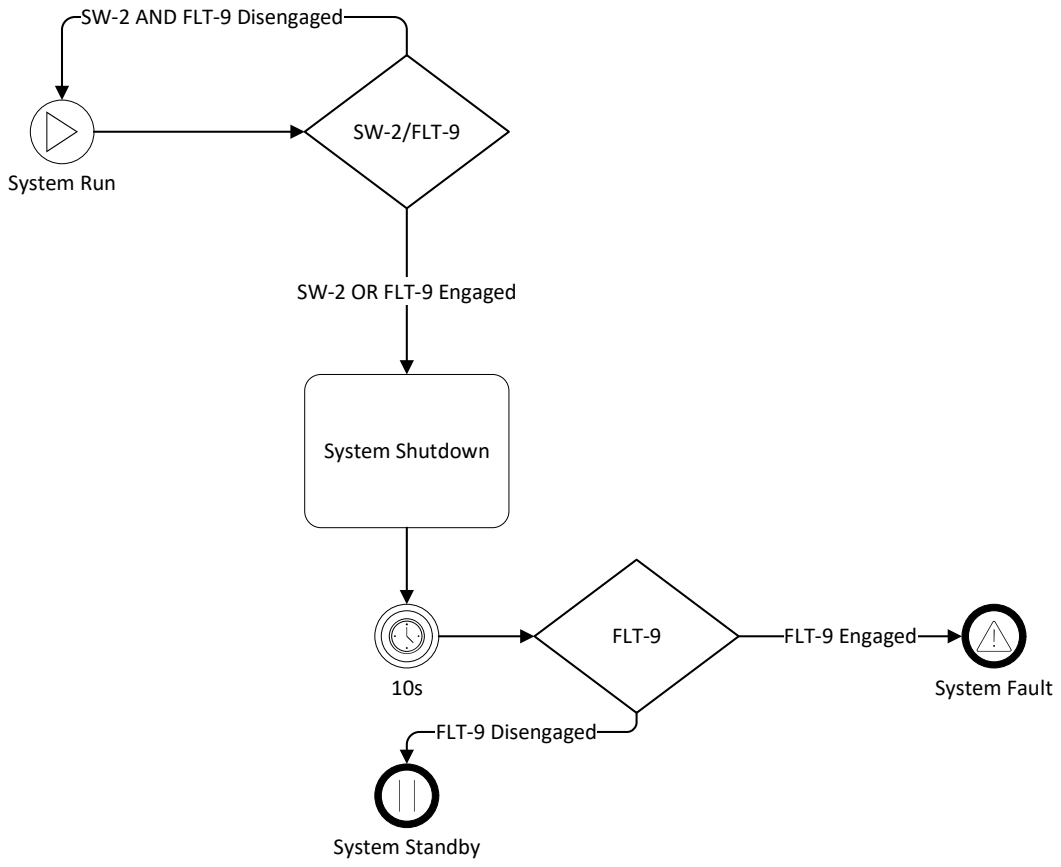
[picture p91: page 6]
System Shutdown; System Run; SW-2/FLT-9; FLT-9; System Standby; FLT-9 Disengaged; System Fault; FLT-9 Engaged

SW-2 AND FLT-9 Disengaged

SW-2 OR FLT-9 Engaged

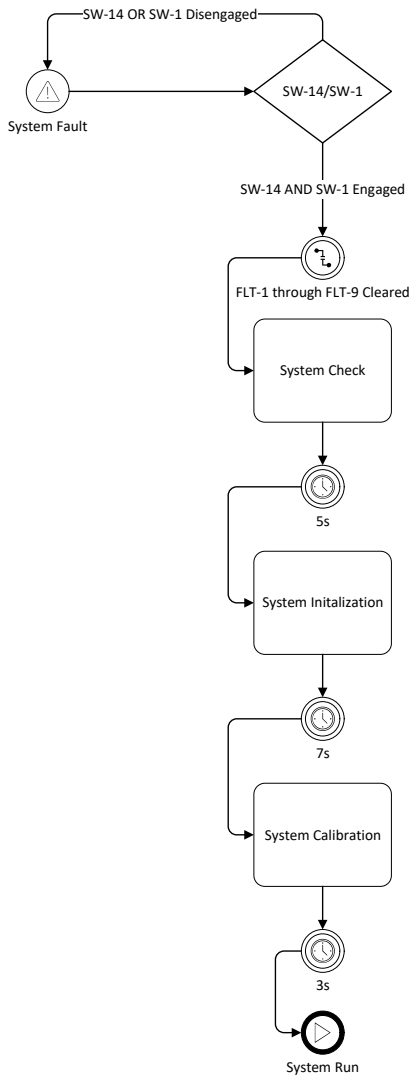
[picture p92: page 7]
System Fault; System Check; System Initalization; System Calibration; System Run

SW-14 OR SW-1 Disengaged

SW-14 AND SW-1 Engaged

FLT-1 through FLT-9 Cleared
