Ovikian/TMEIC-DI-Water-Cooling-Skid-Repo/(commit log)

2026-09-19 Document Add/Updates
    Updating Control Narrative
    Added to PLC Point List
    Created System Sequence Flow Charts
    [PLC Point List.xlsx]
2026-09-20 Documentation Updates
    Cooling skid (no real changes, just switched back to modifying main program)
    Control narrative: Finished terminology. Added system modes, system states, and system sequences. Need to finish adding figure captions. Need to update the control system stuff. Need to add control system to terminology.
    PLC Point List: Add Addresses, Deadman. Tidy Up
    System Sequences: Just need to update names.
    [PLC Point List.xlsx]
2026-09-21 File Updates
    Point List Completed
    [17092026-transmitter-testing.xlsx, PLC Point List.xlsx]
2026-09-21 Digital Twin Update
    New Digital Twin:
    Flow Source Replaced w/ Centrifugal Pump
    Main Loop & DI Loop Head Loss Incporated
    Next steps is to include heat transfer frum pump and heaters, implement Reynold's & Friction, add HX
2026-09-22 Digital Twin Updated
    - Added Friction & Turbulence
    - Added More Accurate HX
    - Added 300W Heater
    - Sized Skid w/ Constant Vol. Vessel
2026-09-22 Digital Twin Update
    - Added & Sized 3-Way Valve
    -Added Check Valve Mechanism
    - Updated Digital Twin Effectively Complete
    - Note: Digital Twin Confirms Potential Pressure Spike When Actuating 3-way valve (See TESTB & TESTA Results) - would like to do more testing.
2026-09-23 Digital Twin Update
    - Added Secondary Pump
    - Added Pump Wind-Up & Wind-Down
    - Improved Check-Valve Mechanism
    - Added 3-Way Valve Actuation
2026-09-23 Digital Twin Update
    - Cleaned up Pump Pressure Readings
2026-09-26 File Updates
    -Testing Procedure Template (Will likely delete)
    -Testing Sheet Created
    - Insignificant Adjustment to Digital Twin
    -PLC Point List Modified
    [Control System Software Testing Sheet.xlsx, PLC Point List.xlsx]
2026-09-27 General Adjustments
    - In Progress
    [Control System Software Testing Sheet.xlsx, PLC Point List.xlsx]
2026-09-27 Documentation Updates
    ROB
    [PLC Point List.xlsx]
2026-09-27 Point List Update & PLC Logic
    - Updated Point List
    - Finished Code Mapping
    [PLC Point List.xlsx]
2026-09-27 File Update
    - Corrected Check Latch Bug in PLC Logic
    - Updated Mapping In Point List and PLC Code
    - Updated Completed Testing
    [Control System Software Testing Sheet.xlsx, PLC Point List.xlsx]
2026-09-28 Final Updates
    - Final Touchups to Code
    - Logging off
    [PLC Point List.xlsx]
2026-09-28 Last Minute Updates
    - Modified Dummy Temp Variables
    - Updated Testing Sheet
    - Added Diagnostics Lamp in Point List, amongst other small changes (naming, and addressing)
    - Copied Prelab Writeup to Repo
    [Control System Software Testing Sheet.xlsx, PLC Point List.xlsx]
2026-09-29 Digital Twin Update
    - Observed Pressure Anomaly
    - Added 4 Gal Tank to imitate reservoir for liquid volume expansion (fixed pressure anomaly)
    - Added PI controller reset mechanism for changed setpoints (increased Robustness of control)
2026-09-29 Digital Twin Updates
    - Improvements to Address Pump Switching
    - General Testing Changes
    [PercDiffSimCalc.xlsx]
2026-09-30 Digital Twin & PLC Point List Update
    - Corrected Typo in Point List
    - Cleared warnings in Matlab
    [PLC Point List.xlsx]
2026-10-01 Robbie
    Check Here
    [PLC Point List.xlsx]
2026-10-02 PLC Logic
    - Fixed Stuck Shutdown Button
2026-10-04 Documentation
    - Added Templates for Visio & Autocad
    - Began Working on Signal Flow Diagrams
    [AUTOCADTEMPLATEARCHD.dwg, test.csv]
2026-10-04 Updated Signal Flow
    - Finished Connections of Signal Flow Diagram
    - Will need to add signal names
    - Aim for Interlock Diagram to be next.
2026-10-05 PLC Logic Update
    - Added Delta SP Regulation
    - Added Initialization Transient Regulation
    - Added Pump Switch Transient Regulation
2026-10-06 PLC Logic Update
    - Determined Method for Recording Data on SD Card.
    - Will begin to record data.
    [PLC OT Networking Data Sheet.xlsx]
2026-10-07 PLC Logic & Testing
    - 3-Way Valve Data Collector Created
    - Conducted test on open loop 3-way valve
    - Analyzed test results
    [10-6-26-3-WAY-VALVE-TEST.xlsx, 10-6-ValveTestRateOfChangeActuation.xlsx, 3WayValveAnalysis.xlsx]
2026-10-08 PLC Logic & Testing Doc
    - More Testing was done this evening (10/7)
    [10-6-ValveTestRateOfChangeActuation.xlsx]
2026-10-10 Point List, Testing, & PLC Logic
    - New .csv Generator for Point List (will need to test)
    - Plotted Heat Exchanger Trends
    - Added Comments to PLC Logic
2026-10-13 PLC Logic Update
    - Created Structs for Better Organization
    - Fixed Calibration Latching
2026-10-22 Adding wire color convention
2026-10-24 PLC Logic
    Begun Creation of Main Program.
    Switched Main Program into ST rather than LD
2026-10-25 Flow & Conductivity Tests
    Conductivity and Flow Test Results
2026-10-26 More Testing Documentation
    Applied First Order Low Pass Filter To Conductivity & Flow Meters For Noise Reduction. New Results Added in Word DOC
2026-10-29 Digital Twin Update
    Fixed 3-Way Valve Orientation
    Adjusted Controller to be Ideal + for new valve orienation
2026-11-03 Documentation Updates
    - Adding Detailed Comments to PLC Logic
    - Finished Flow Diagrams for Function Blocks
2026-11-09 PLC Logic Update
    - Added Button For Setpoint CHange
    - PLC Pointlist Button Added
2026-11-09 PLC Updates
    - Changed fan functionality to meet customer specifications.
2026-11-10 PLC Logic
    - Consolidated Manual Fan Control and Manual Valve control into single Manual Mode.
